Churrosoft/OpenEFI-Wideband/carrier_fw/src/can/readme.md

esta libreria se encarga de todo el manejo del CAN-Bus hacia el exterior,
es configurable un solo "modulo/protocolo" a utilizar de momento (si es que lo termino en algun momento)
