Churrosoft/OpenEFI-Wideband/pcb/wideband_v3/3D/DL7A-3 RED.step

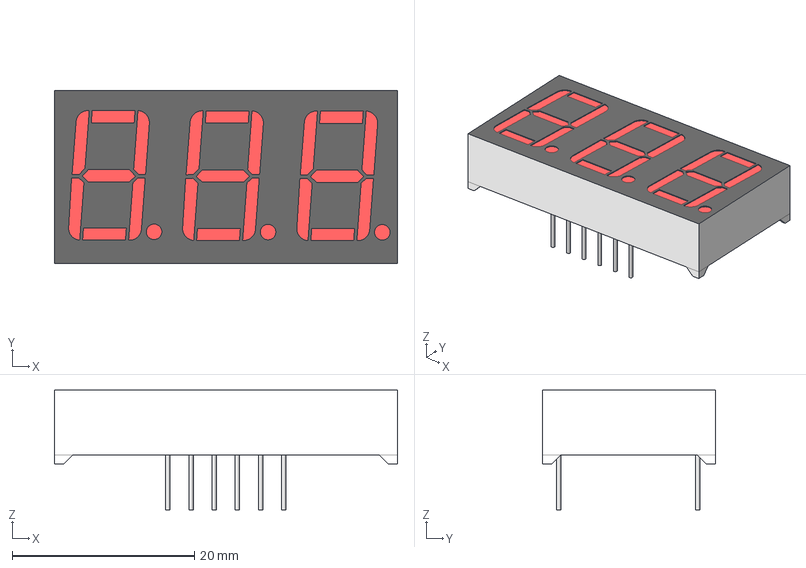
[picture p1: CAD file, 2023-12-04]
pcb/wideband_v3/3D/DL7A-3 RED.step
37.6 x 19.0 x 13.1 mm
