Churrosoft/OpenEFI-Wideband/pcb/wideband_v3/3D/39-28-1043--3DModel-STEP-361473.STEP

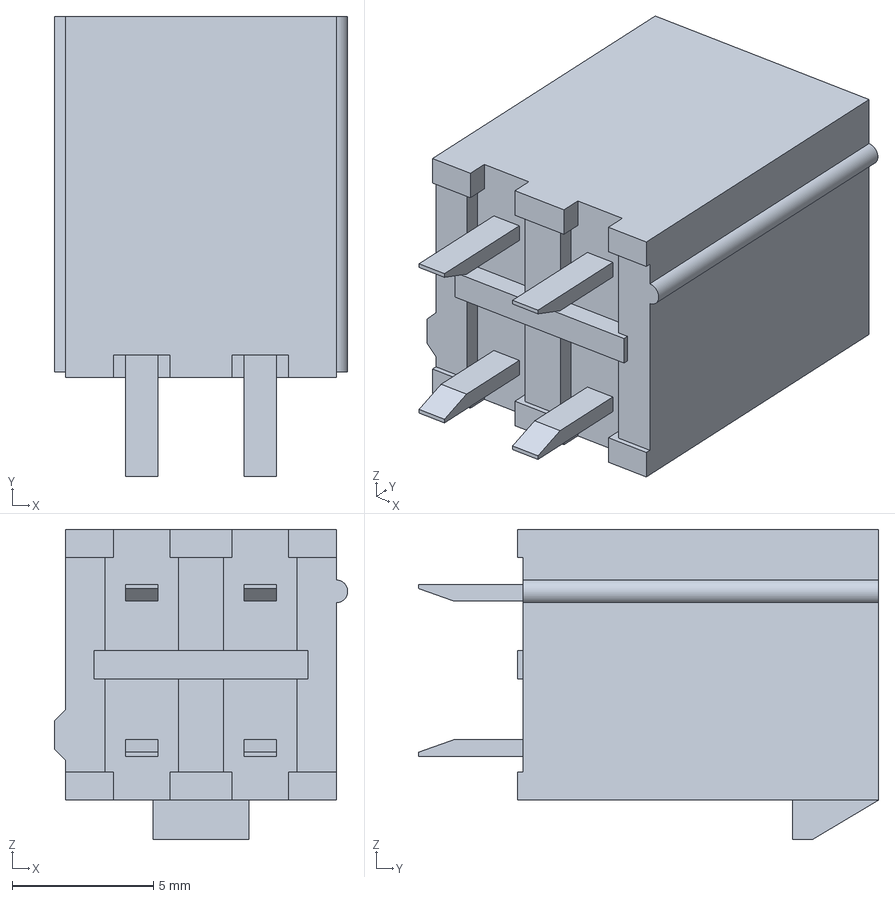
[picture p2: CAD file, 2023-12-04]
pcb/wideband_v3/3D/39-28-1043--3DModel-STEP-361473.STEP
10.4 x 16.3 x 11.0 mm
