Churrosoft/OpenEFI-Wideband/pcb/wideband_v3/3D/462071012.stp

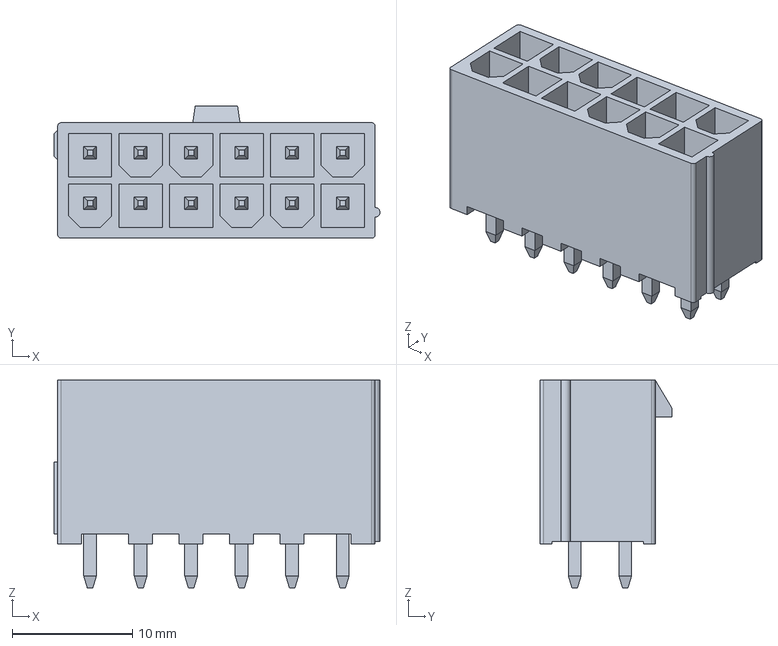
[picture p3: CAD file, 2023-12-04]
pcb/wideband_v3/3D/462071012.stp
27.1 x 11.0 x 17.3 mm
