Churrosoft/OpenEFI-Wideband/pcb/wideband_v3/displays/7_Segment_LED_v1/7_Segment_LED_v1.kicad_pcb

## KiCad design pcb/wideband_v3/displays/7_Segment_LED_v1/7_Segment_LED_v1.kicad_pcb (2024-04-12, an earlier design)

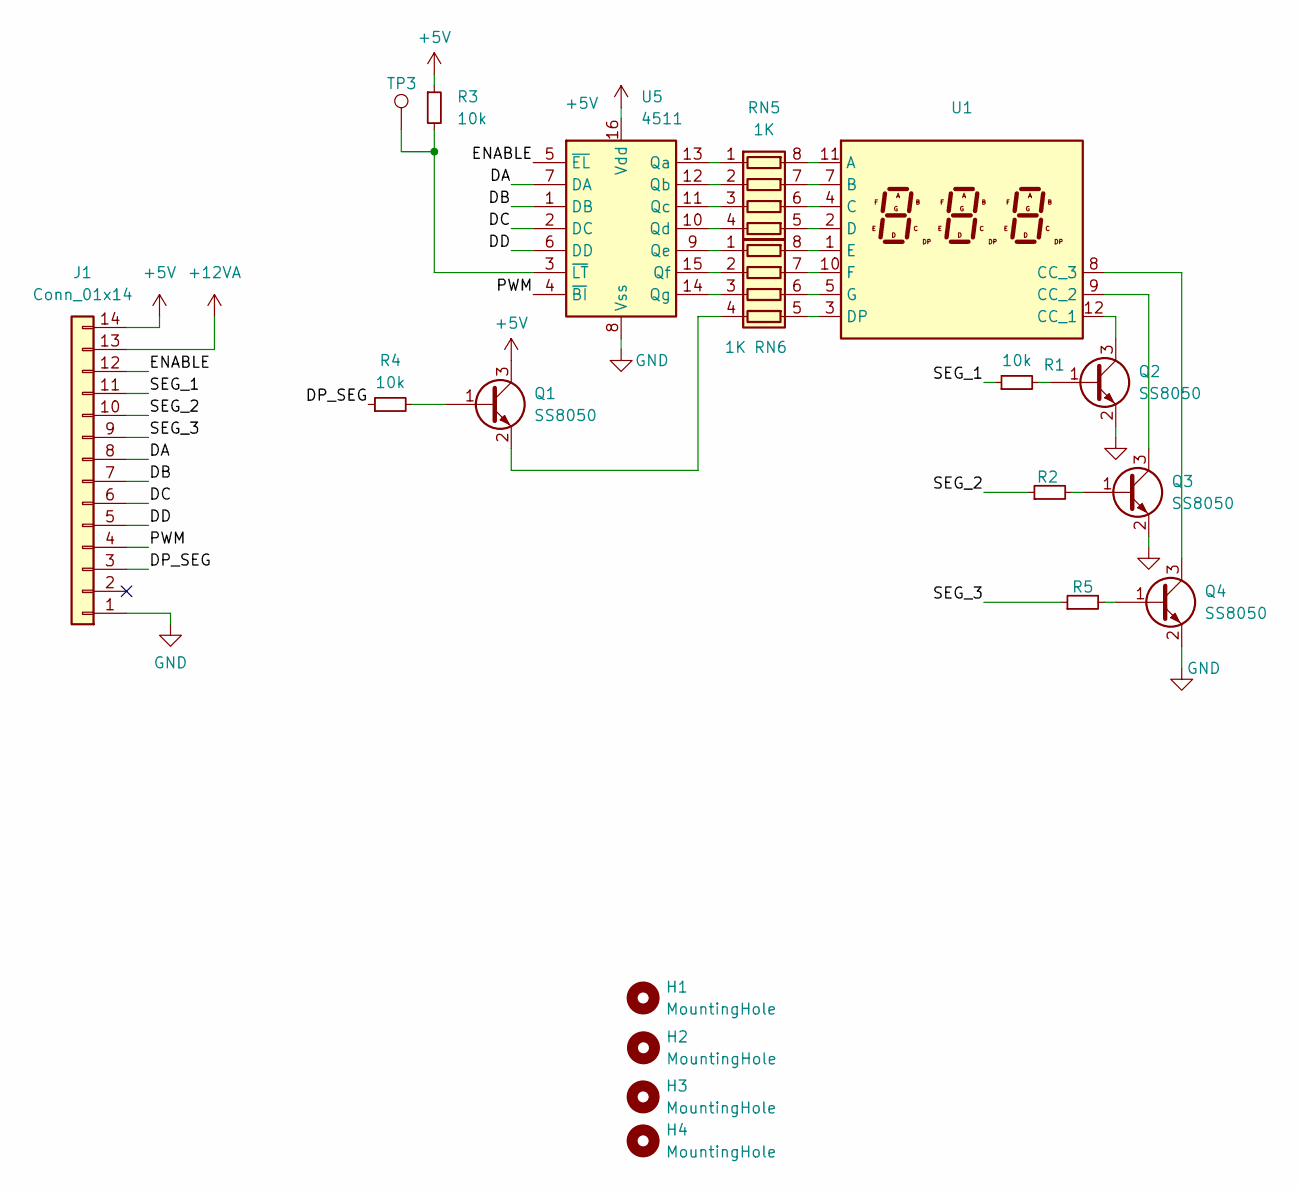
[picture p4: schematic 7_Segment_LED_v1.kicad_sch]

Parts:
H1, H2, H3, H4: MountingHole; MountingHole_3.2mm_M3_Pad_Via
J1: Conn_01x14; PinHeader_2x07_P2.54mm_Vertical
Q1, Q2, Q3, Q4: SS8050; SOT-23-3; LCSC C2150
R1, R2, R3, R4, R5: 10k; R_0603_1608Metric
RN5, RN6: 1K; R_Array_Convex_4x0603; LCSC C160614
TP3: TestPoint; TestPoint_Pad_1.0x1.0mm
U1: PinHeader_2x12_P2.00mm_Vertical
U5: 4511; SOP-16_4.55x10.3mm_P1.27mm; LCSC C5145431

Connections:
+5V: J1.14, Q1.3 (C), R3.1, U5.16 (Vdd)
+12VA: J1.13
/DA: J1.8, U5.7 (DA)
/DB: J1.7, U5.1 (DB)
/DC: J1.6, U5.2 (DC)
/DD: J1.5, U5.6 (DD)
/DP_SEG: J1.3, R4.1
/ENABLE: J1.12, U5.5 (~EL)
/PWM: J1.4, U5.4 (~BI)
/SEG_1: J1.11, R1.1
/SEG_2: J1.10, R2.1
/SEG_3: J1.9, R5.1
GND: J1.1, Q2.2 (E), Q3.2 (E), Q4.2 (E), U5.8 (Vss)
unnamed: Q1.1 (B), R4.2
unnamed: Q1.2 (E), RN6.4 (R4.1)
unnamed: Q2.1 (B), R1.2
unnamed: Q2.3 (C), U1.12 (CC_1)
unnamed: Q3.1 (B), R2.2
unnamed: Q3.3 (C), U1.9 (CC_2)
unnamed: Q4.1 (B), R5.2
unnamed: Q4.3 (C), U1.8 (CC_3)
unnamed: RN5.1 (R1.1), U5.13 (Qa)
unnamed: RN5.8 (R1.2), U1.11 (A)
unnamed: RN5.2 (R2.1), U5.12 (Qb)
unnamed: RN5.7 (R2.2), U1.7 (B)
unnamed: RN5.3 (R3.1), U5.11 (Qc)
unnamed: RN5.6 (R3.2), U1.4 (C)
unnamed: RN5.4 (R4.1), U5.10 (Qd)
unnamed: RN5.5 (R4.2), U1.2 (D)
unnamed: RN6.1 (R1.1), U5.9 (Qe)
unnamed: RN6.8 (R1.2), U1.1 (E)
unnamed: RN6.2 (R2.1), U5.15 (Qf)
unnamed: RN6.7 (R2.2), U1.10 (F)
unnamed: RN6.3 (R3.1), U5.14 (Qg)
unnamed: RN6.6 (R3.2), U1.5 (G)
unnamed: RN6.5 (R4.2), U1.3 (DP)
unnamed: R3.2, TP3.1, U5.3 (~LT)

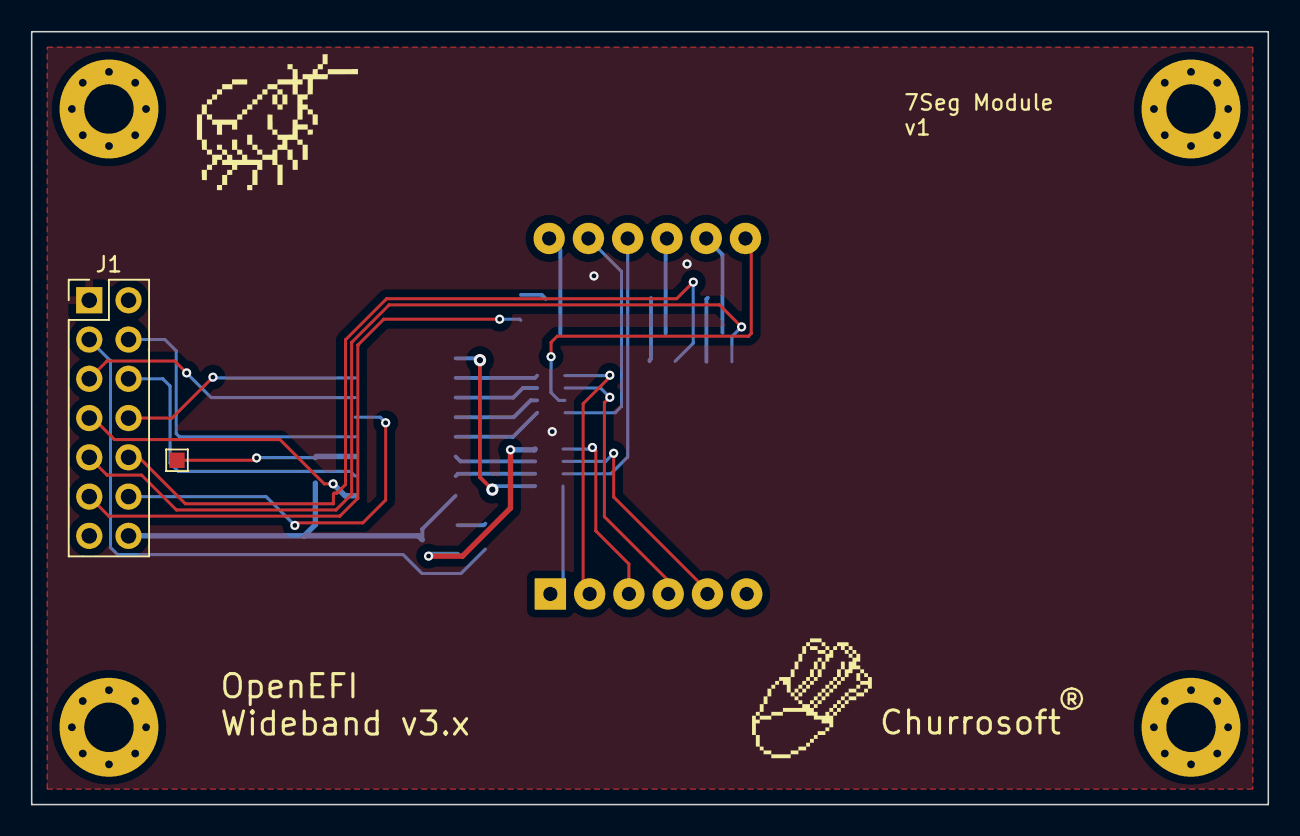
[picture p5: board 7_Segment_LED_v1.kicad_pcb from above]

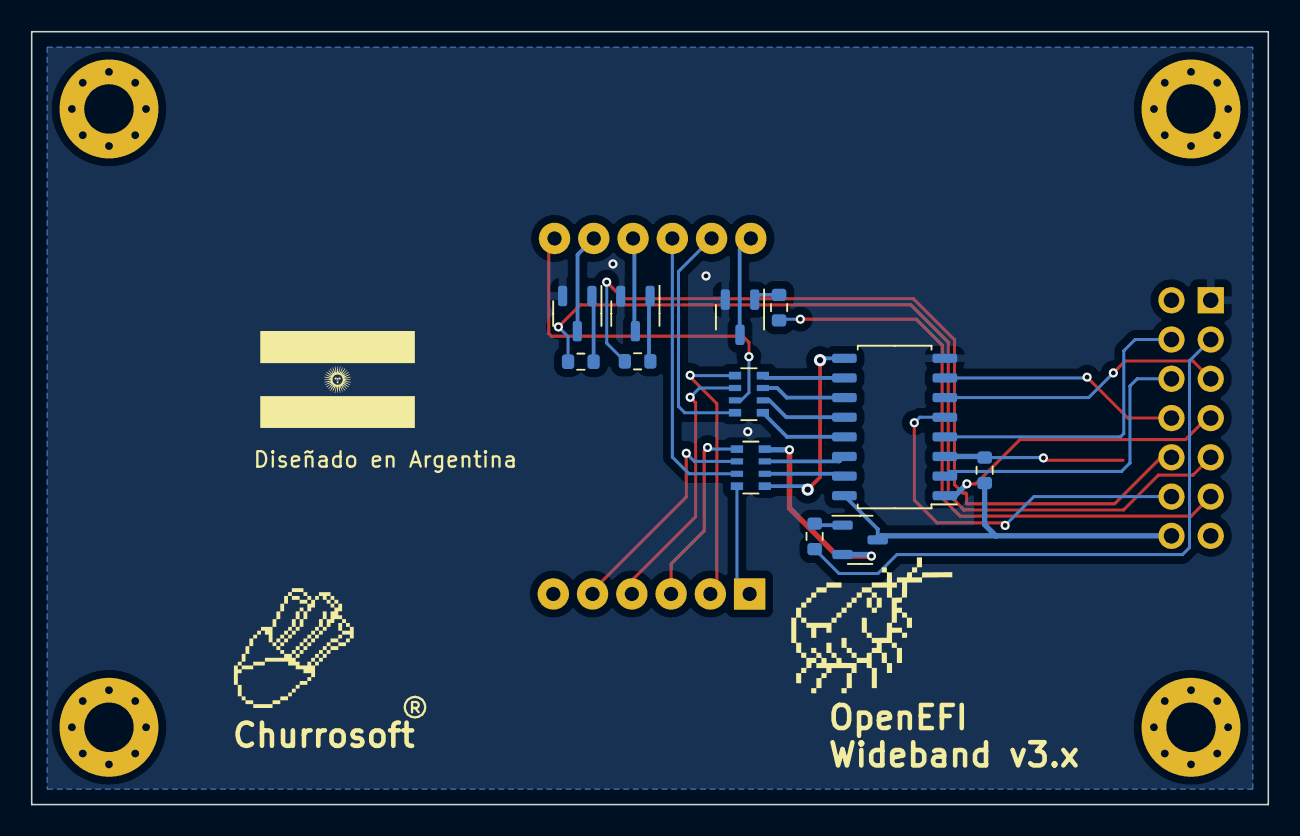
[picture p6: board 7_Segment_LED_v1.kicad_pcb from below]

Board: 2 copper layers, 80.0 x 50.0 mm, 19 parts (12 on the bottom side), 36 nets.
