Churrosoft/OpenEFI-Wideband/pcb/wideband_v3/Wideband_v3.kicad_pcb

## KiCad design pcb/wideband_v3/Wideband_v3.kicad_pcb (2024-04-07)

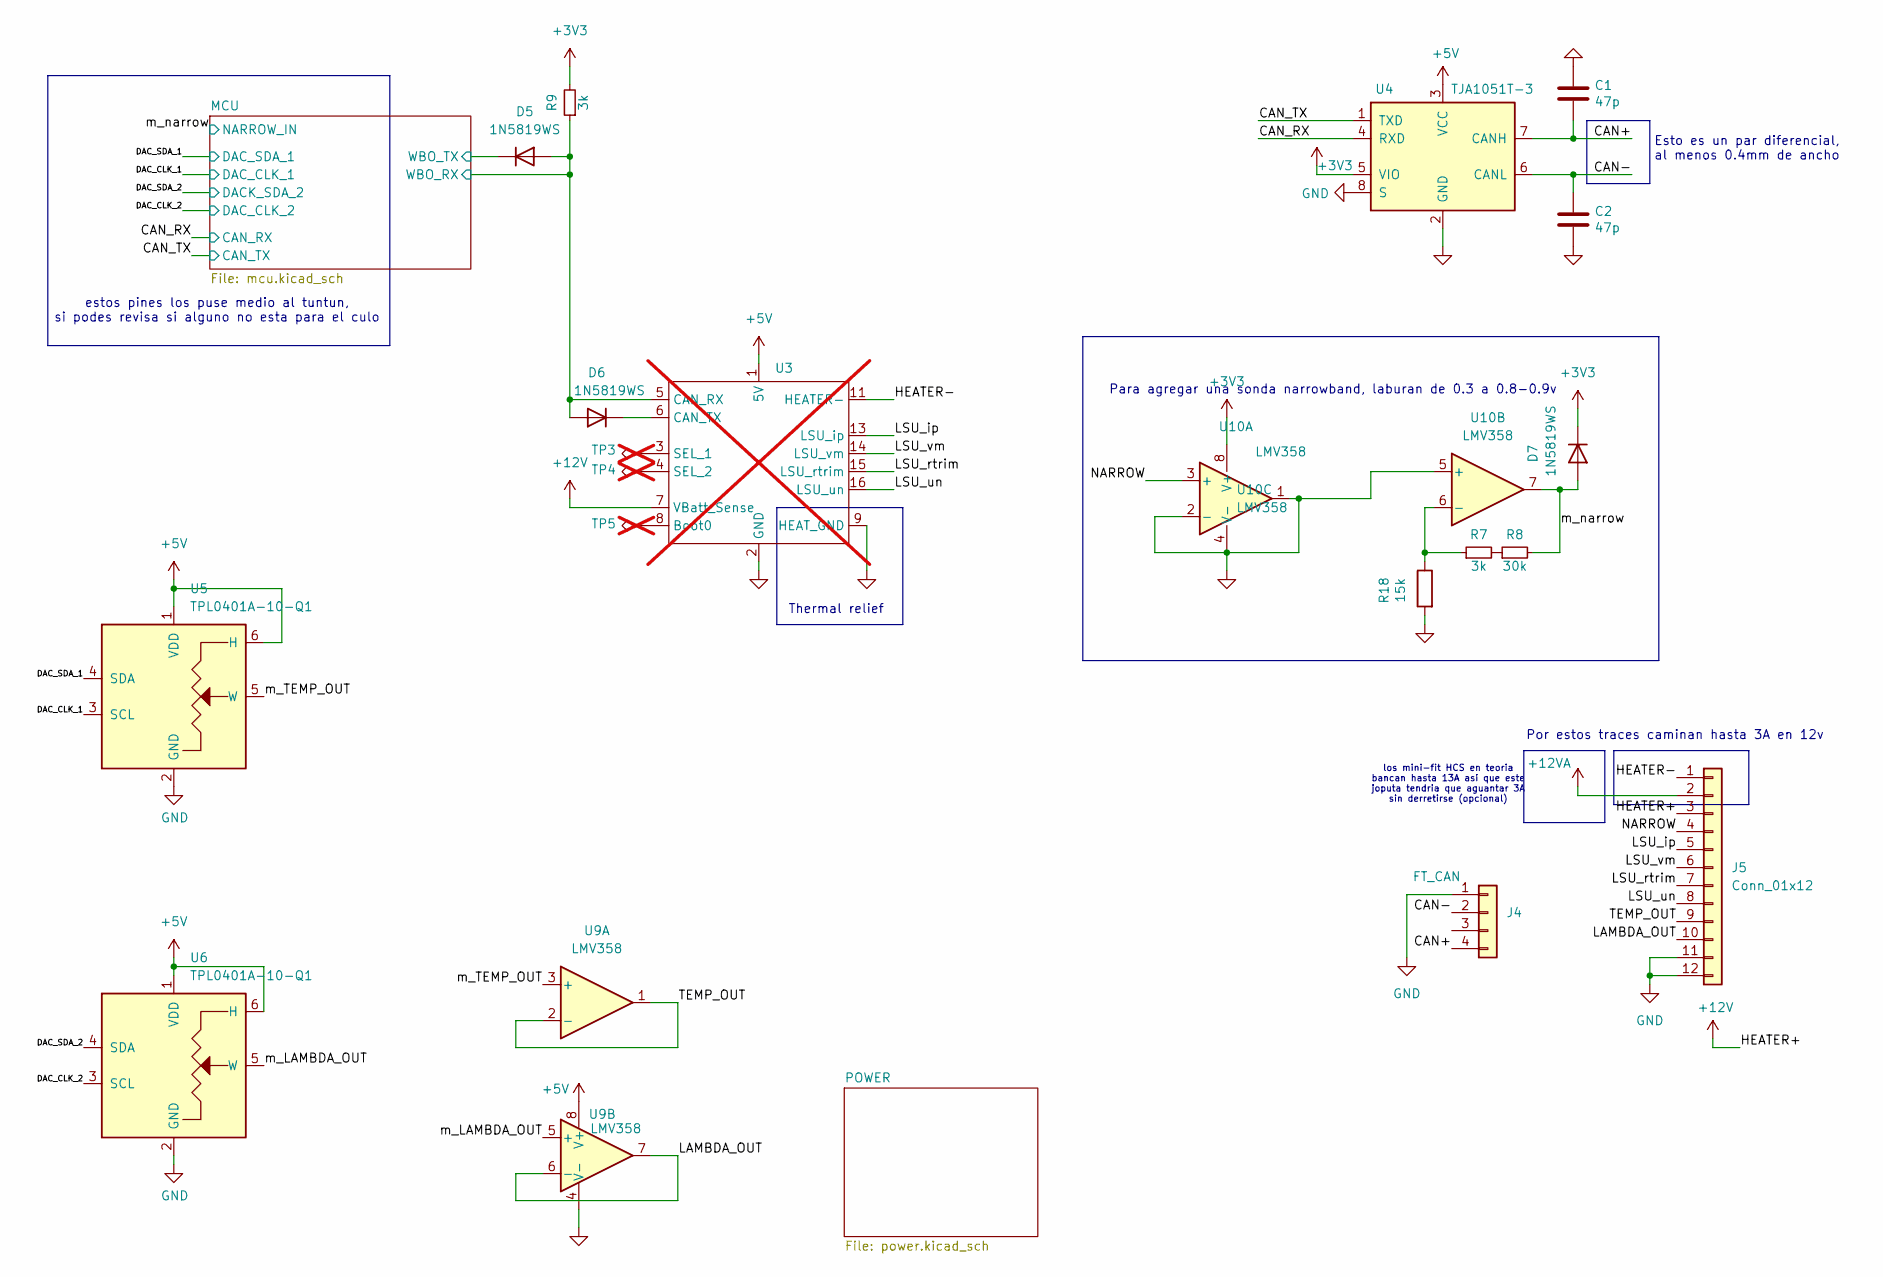
[picture p7: schematic Wideband_v3.kicad_sch, OpenEFI WBO Carrier Board]

Parts:
C1, C2: 47p; C_0603_1608Metric; LCSC C105622
D5, D6, D7: 1N5819WS; D_SOD-323F; LCSC C191023
J4: FT_CAN; Molex_Mini-Fit_Jr_5566-04A_2x02_P4.20mm_Vertical; LCSC C586650
J5: Conn_01x12; Molex_Mini-Fit_Jr_5566-12A2_2x06_P4.20mm_Vertical
R7, R9: 3k; R_0603_1608Metric; LCSC C4211
R8: 30k; R_0603_1608Metric; LCSC C22984
R18: 15k; R_0603_1608Metric; LCSC C100780
TP3, TP4, TP5: TestPoint_Alt; TestPoint_Pad_1.0x1.0mm; not fitted
U3: RusEFI_WBO; not fitted
U4: TJA1051T-3; SOP-8_3.9x4.9mm_P1.27mm; LCSC C5342108
U5, U6: TPL0401A-10-Q1; Texas_R-PDSO-G6; LCSC C2666599
U9, U10: LMV358; SOIC-8_3.9x4.9mm_P1.27mm; LCSC C63813

Connections:
+3V3: D7.1 (K), R9.2, U4.5 (VIO), U10.8 (V+); also elsewhere on the board
+5V: U3.1 (5V), U4.3 (VCC), U5.1 (VDD), U5.6 (H), U6.1 (VDD), U6.6 (H), U9.8 (V+); also elsewhere on the board
+12V: J5.3, U3.7 (VBatt_Sense); also elsewhere on the board
+12VA: J5.2; also elsewhere on the board
/CAN+: C1.2, J4.4, U4.7 (CANH)
/CAN-: C2.1, J4.2, U4.6 (CANL)
/CAN_RX: U4.4 (RXD); also elsewhere on the board
/CAN_TX: U4.1 (TXD); also elsewhere on the board
/DAC_CLK_1: U5.3 (SCL); also elsewhere on the board
/DAC_CLK_2: U6.3 (SCL); also elsewhere on the board
/DAC_SDA_1: U5.4 (SDA); also elsewhere on the board
/DAC_SDA_2: U6.4 (SDA); also elsewhere on the board
/HEATER-: J5.1, U3.11 (HEATER-), U3.12 (HEATER-)
/LAMBDA_OUT: J5.10, U9.6 (-), U9.7
/LSU_ip: J5.5, U3.13 (LSU_ip)
/LSU_rtrim: J5.7, U3.15 (LSU_rtrim)
/LSU_un: J5.8, U3.16 (LSU_un)
/LSU_vm: J5.6, U3.14 (LSU_vm)
/MCU/WBO_RX: D5.2 (A), D6.2 (A), R9.1, U3.5 (CAN_RX); also elsewhere on the board
/MCU/WBO_TX: D5.1 (K); also elsewhere on the board
/NARROW: J5.4, U10.3 (+)
/TEMP_OUT: J5.9, U9.1, U9.2 (-)
/m_LAMBDA_OUT: U6.5 (W), U9.5 (+)
/m_TEMP_OUT: U5.5 (W), U9.3 (+)
/m_narrow: D7.2 (A), R8.2, U10.7; also elsewhere on the board
GND: C1.1, C2.2, J4.1, J5.11, J5.12, R18.2, U3.2 (GND), U3.9 (HEAT_GND), U3.10 (HEAT_GND2), U4.2 (GND), U4.8 (S), U5.2 (GND), U6.2 (GND), U9.4 (V-), U10.1, U10.2 (-), U10.4 (V-), U10.5 (+); also elsewhere on the board
unnamed: D6.1 (K), U3.6 (CAN_TX)
unnamed: R7.2, R8.1
unnamed: TP5.1, U3.8 (Boot0)
unnamed: TP3.1, U3.3 (SEL_1)
unnamed: TP4.1, U3.4 (SEL_2)
unnamed: R7.1, R18.1, U10.6 (-)

Notes on the sheet:
Thermal relief
Para agregar una sonda narrowband, laburan de 0.3 a 0.8-0.9v
Esto es un par diferencial, al menos 0.4mm de ancho
Por estos traces caminan hasta 3A en 12v
los mini-fit HCS en teoria bancan hasta 13A asi que este joputa tendria que aguantar 3A sin derretirse (opcional)
estos pines los puse medio al tuntun, si podes revisa si alguno no esta para el culo

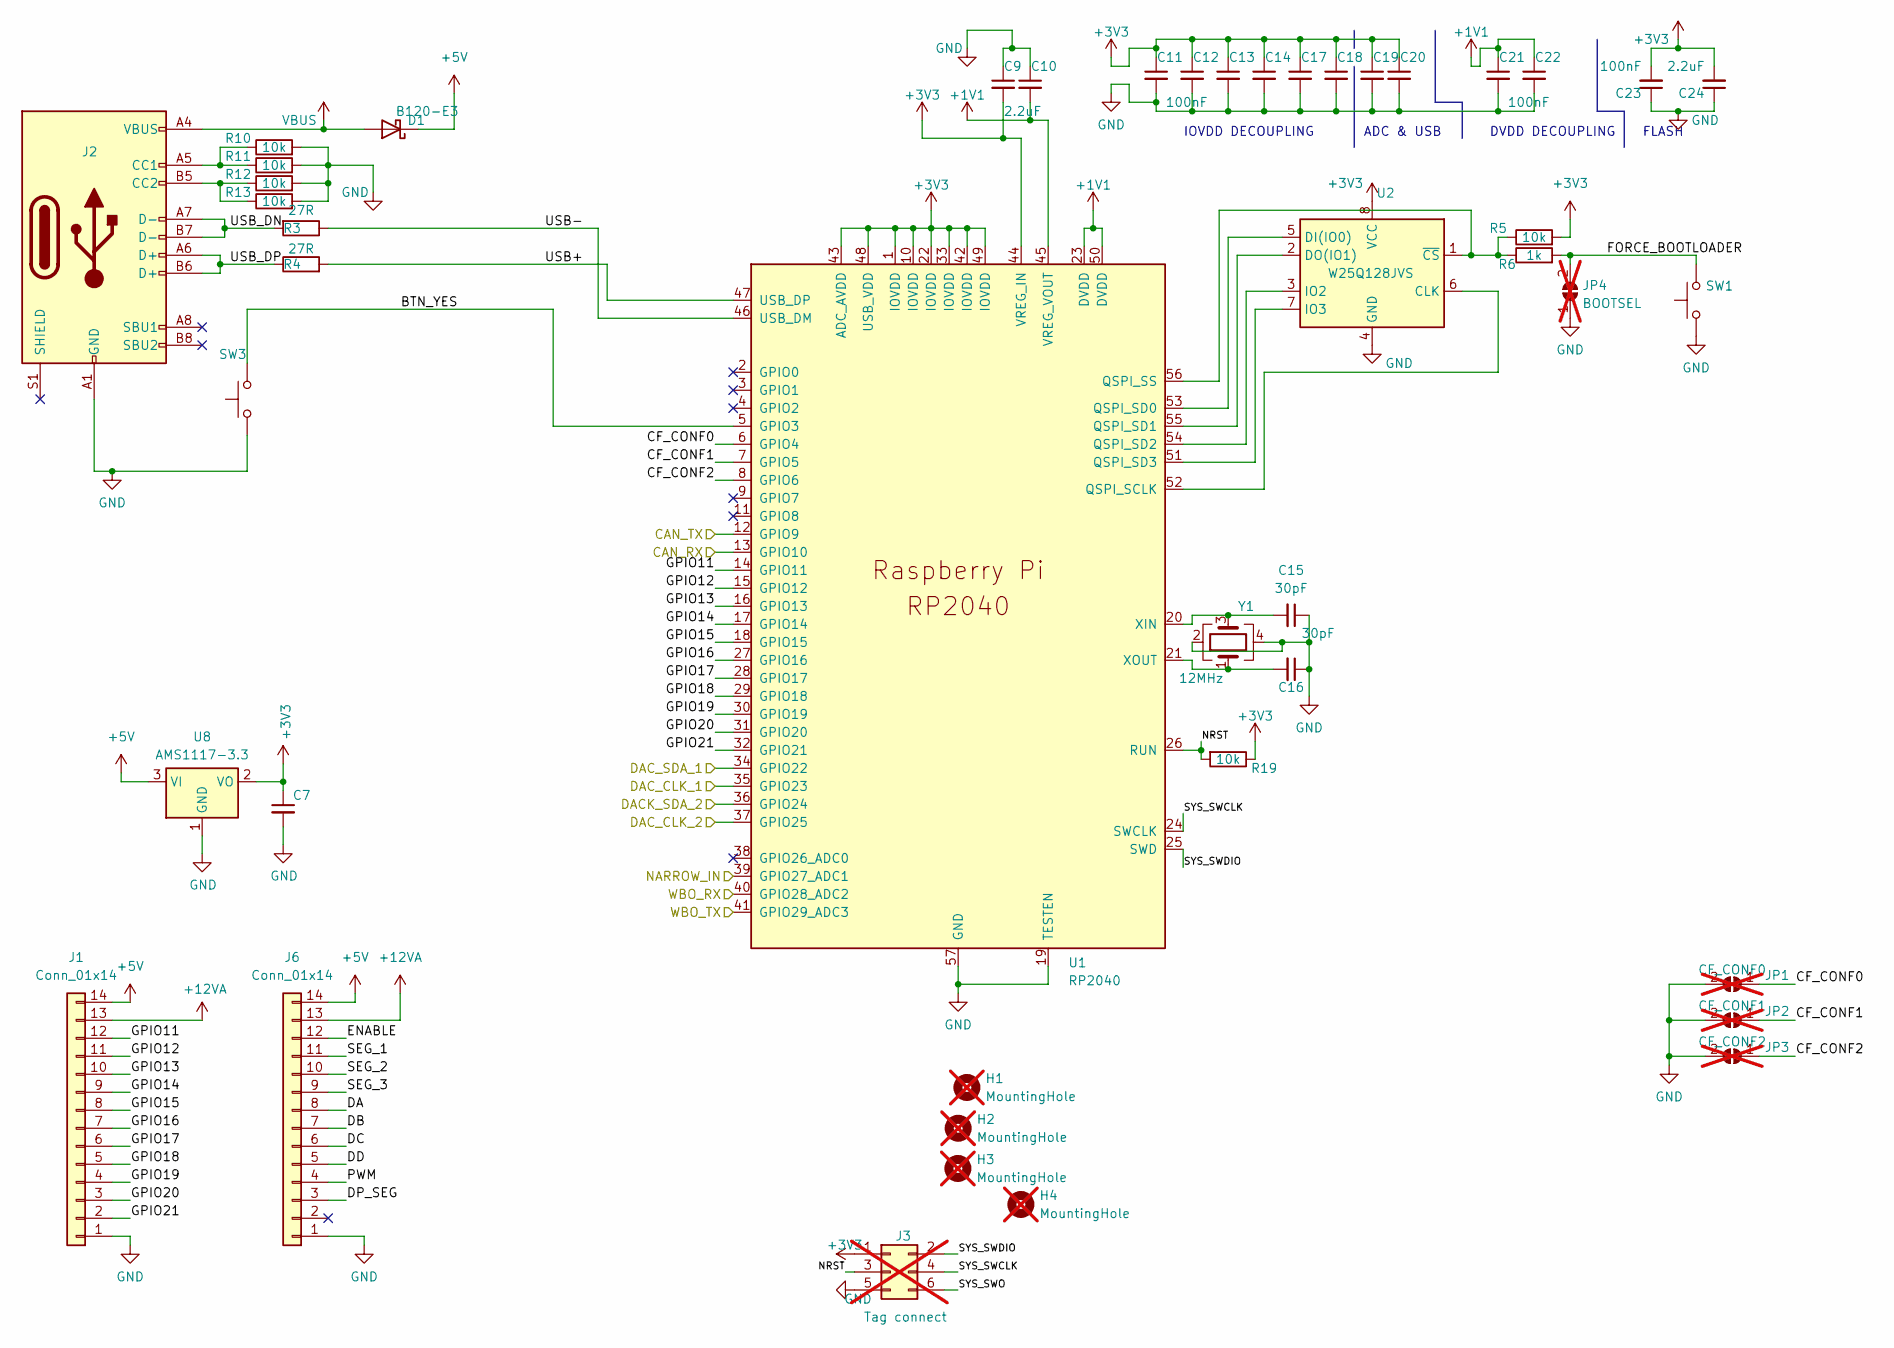
[picture p8: schematic mcu.kicad_sch, OpenEFI WBO Carrier Board]

Parts:
C7, C11, C12, C13, C14, C17, C18, C19, C20, C21, C22, C23: 100nF; C_0603_1608Metric; LCSC C14663
C9, C10, C24: 2.2uF; C_0805_2012Metric; LCSC C49217
C15, C16: 30pF; C_0402_1005Metric; LCSC C18164620
D1: B120-E3; D_SMA; LCSC C84343
H1, H2, H3, H4: MountingHole; MountingHole_3.2mm_M3_Pad_Via; not fitted
J1: Conn_01x14; PinHeader_2x07_P2.54mm_Vertical; LCSC C7494795
J2: USB_C_Receptacle_USB2.0; USB_C_Receptacle_HRO_TYPE-C-31-M-12; LCSC C165948
J3: Tag connect; Tag-Connect_TC2030-IDC-NL_2x03_P1.27mm_Vertical; not fitted
J6: Conn_01x14; PinHeader_2x07_P2.54mm_Vertical
JP1: CF_CONF0; SolderJumper-2_P1.3mm_Open_TrianglePad1.0x1.5mm; not fitted
JP2: CF_CONF1; SolderJumper-2_P1.3mm_Open_TrianglePad1.0x1.5mm; not fitted
JP3: CF_CONF2; SolderJumper-2_P1.3mm_Open_TrianglePad1.0x1.5mm; not fitted
JP4: BOOTSEL; SolderJumper-2_P1.3mm_Open_TrianglePad1.0x1.5mm; not fitted
R3, R4: 27R; R_0603_1608Metric; LCSC C25190
R5, R10, R11, R12, R13, R19: 10k; R_0603_1608Metric; LCSC C115324
R6: 1k; R_0603_1608Metric; LCSC C21190
SW1: Key0; SW_Push_1P1T_XKB_TS-1187A; LCSC C412370
SW3: Key1; SW_SPST_Omron_B3F-315x_Angled; LCSC C2798927
U1: RP2040; QFN-56-1EP_7x7mm_P0.4mm_EP3.2x3.2mm; LCSC C2040
U2: W25Q128JVS; SOIC-8_5.23x5.23mm_P1.27mm; LCSC C97521
U8: AMS1117-3.3; SOT-223-3_TabPin2; LCSC C6186
Y1: 12MHz; Crystal_SMD_3225-4Pin_3.2x2.5mm; LCSC C9002

Connections:
+1V1: C10.2, C21.1, C22.1, U1.23 (DVDD), U1.45 (VREG_VOUT), U1.50 (DVDD)
+3V3: C7.1, C9.2, C11.1, C12.1, C13.1, C14.1, C17.1, C18.1, C19.1, C20.1, C23.2, C24.2, J3.1, R5.2, R19.1, U1.1 (IOVDD), U1.10 (IOVDD), U1.22 (IOVDD), U1.33 (IOVDD), U1.42 (IOVDD), U1.43 (ADC_AVDD), U1.44 (VREG_IN), U1.48 (USB_VDD), U1.49 (IOVDD), U2.8 (VCC), U8.2 (VO); also elsewhere on the board
+5V: D1.1 (K), J1.14, J6.14, U8.3 (VI); also elsewhere on the board
+12VA: J1.13, J6.13; also elsewhere on the board
/CAN_RX: U1.13 (GPIO10); also elsewhere on the board
/CAN_TX: U1.12 (GPIO9); also elsewhere on the board
/DAC_CLK_1: U1.35 (GPIO23); also elsewhere on the board
/DAC_CLK_2: U1.37 (GPIO25); also elsewhere on the board
/DAC_SDA_1: U1.34 (GPIO22); also elsewhere on the board
/DAC_SDA_2: U1.36 (GPIO24); also elsewhere on the board
/MCU/BTN_YES: SW3.2, U1.5 (GPIO3)
/MCU/CF_CONF0: JP1.1 (A), U1.6 (GPIO4)
/MCU/CF_CONF1: JP2.1 (A), U1.7 (GPIO5)
/MCU/CF_CONF2: JP3.1 (A), U1.8 (GPIO6)
/MCU/FORCE_BOOTLOADER: JP4.2 (B), R6.2, SW1.2
/MCU/GPIO11: J1.12, U1.14 (GPIO11)
/MCU/GPIO12: J1.11, U1.15 (GPIO12)
/MCU/GPIO13: J1.10, U1.16 (GPIO13)
/MCU/GPIO14: J1.9, U1.17 (GPIO14)
/MCU/GPIO15: J1.8, U1.18 (GPIO15)
/MCU/GPIO16: J1.7, U1.27 (GPIO16)
/MCU/GPIO17: J1.6, U1.28 (GPIO17)
/MCU/GPIO18: J1.5, U1.29 (GPIO18)
/MCU/GPIO19: J1.4, U1.30 (GPIO19)
/MCU/GPIO20: J1.3, U1.31 (GPIO20)
/MCU/GPIO21: J1.2, U1.32 (GPIO21)
/MCU/NRST: J3.3, R19.2, U1.26 (RUN)
/MCU/SYS_SWCLK: J3.4, U1.24 (SWCLK)
/MCU/SYS_SWDIO: J3.2, U1.25 (SWD)
/MCU/SYS_SWO: J3.6
/MCU/USB+: R4.2, U1.47 (USB_DP)
/MCU/USB-: R3.1, U1.46 (USB_DM)
/MCU/USB_DN: J2.A7 (D-), J2.B7 (D-), R3.2
/MCU/USB_DP: J2.A6 (D+), J2.B6 (D+), R4.1
/MCU/WBO_RX: U1.40 (GPIO28_ADC2); also elsewhere on the board
/MCU/WBO_TX: U1.41 (GPIO29_ADC3); also elsewhere on the board
/m_narrow: U1.39 (GPIO27_ADC1); also elsewhere on the board
GND: C7.2, C9.1, C10.1, C11.2, C12.2, C13.2, C14.2, C15.1, C16.1, C17.2, C18.2, C19.2, C20.2, C21.2, C22.2, C23.1, C24.1, J1.1, J2.A1 (GND), J2.A12 (GND), J2.B1 (GND), J2.B12 (GND), J3.5, JP1.2 (B), JP2.2 (B), JP3.2 (B), JP4.1 (A), R10.2, R11.2, R12.2, R13.2, SW1.1, SW3.1, U1.19 (TESTEN), U1.57 (GND), U2.4 (GND), U8.1 (GND), Y1.2, Y1.4; also elsewhere on the board
unnamed: J2.A5 (CC1), R10.1, R11.1
unnamed: J2.B5 (CC2), R12.1, R13.1
unnamed: U1.52 (QSPI_SCLK), U2.6 (CLK)
unnamed: U1.53 (QSPI_SD0), U2.5 (DI(IO0))
unnamed: U1.55 (QSPI_SD1), U2.2 (DO(IO1))
unnamed: U1.54 (QSPI_SD2), U2.3 (IO2)
unnamed: U1.51 (QSPI_SD3), U2.7 (IO3)
unnamed: R5.1, R6.1, U1.56 (QSPI_SS), U2.1 (~CS)
unnamed: C15.2, U1.20 (XIN), Y1.3
unnamed: C16.2, U1.21 (XOUT), Y1.1
VBUS: D1.2 (A), J2.A4 (VBUS), J2.A9 (VBUS), J2.B4 (VBUS), J2.B9 (VBUS)

Notes on the sheet:
FLASH
ADC & USB
DVDD DECOUPLING
IOVDD DECOUPLING

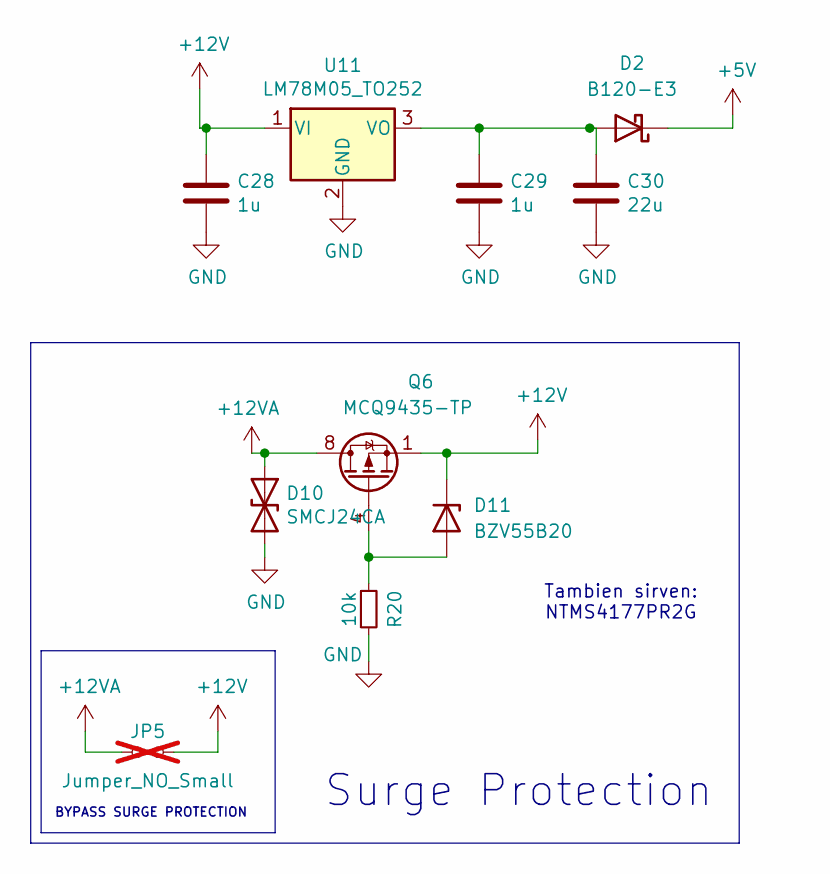
[picture p9: schematic power.kicad_sch, OpenEFI WBO Carrier Board]

Parts:
C28, C29: 1u; C_0603_1608Metric; LCSC C15849
C30: 22u; C_0805_2012Metric; LCSC C45783
D2: B120-E3; D_SMA; LCSC C84343
D10: SMCJ24CA; D_SMC; LCSC C151279
D11: BZV55B20; D_MiniMELF; LCSC C550392
JP5: Jumper_NO_Small; SolderJumper-2_P1.3mm_Open_RoundedPad1.0x1.5mm; not fitted
Q6: MCQ9435-TP; SOIC-8_3.9x4.9mm_P1.27mm; LCSC C586650
R20: 10k; R_0603_1608Metric; LCSC C115324
U11: LM78M05_TO252; TO-252-2; LCSC C58069

Connections:
+5V: D2.1 (K); also elsewhere on the board
+12V: C28.1, D11.1 (K), JP5.2, Q6.1 (S), Q6.2 (S), Q6.3 (S), U11.1 (VI); also elsewhere on the board
+12VA: D10.1 (A1), JP5.1, Q6.5 (D), Q6.6 (D), Q6.7 (D), Q6.8 (D); also elsewhere on the board
GND: C28.2, C29.2, C30.2, D10.2 (A2), R20.2, U11.2 (GND); also elsewhere on the board
unnamed: C29.1, C30.1, D2.2 (A), U11.3 (VO)
unnamed: D11.2 (A), Q6.4 (G), R20.1

Notes on the sheet:
BYPASS SURGE PROTECTION
Tambien sirven: NTMS4177PR2G
Surge Protection

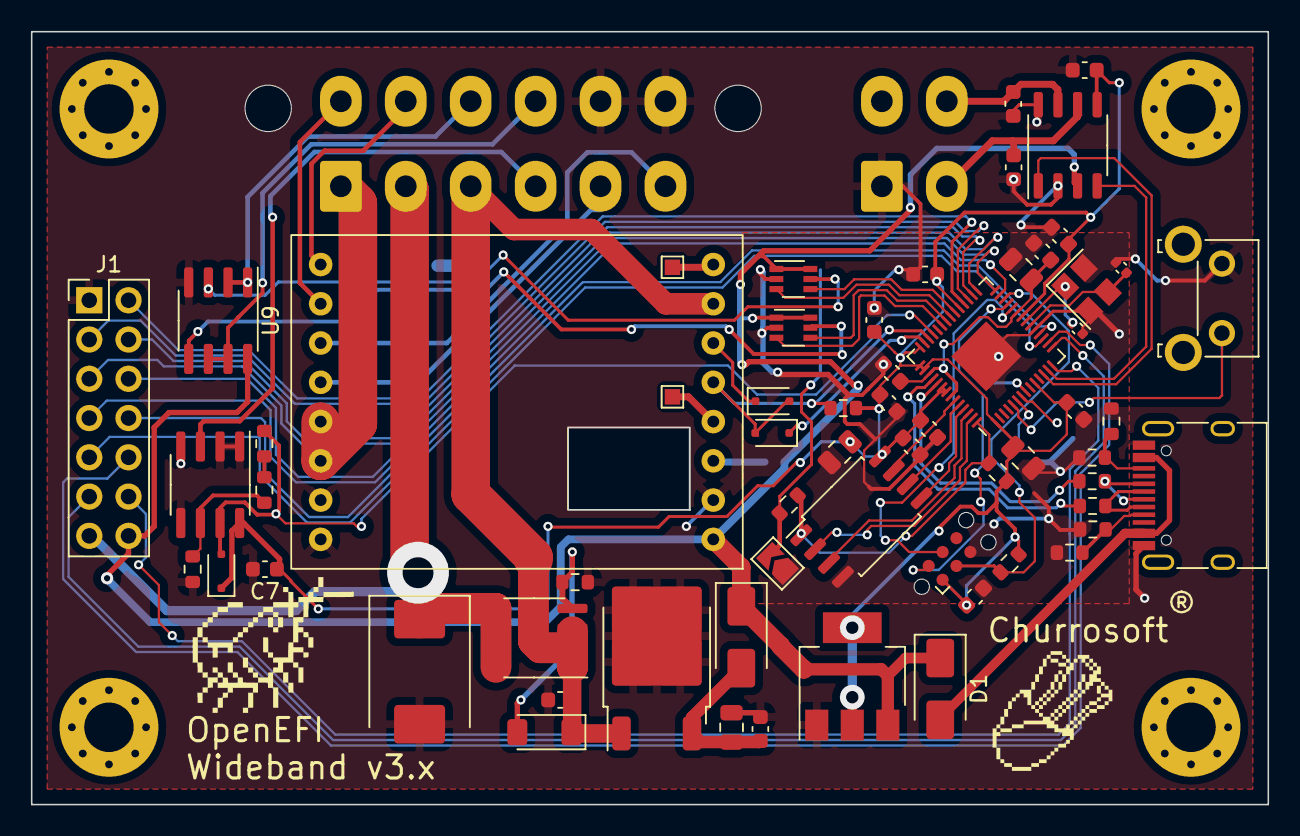
[picture p10: board Wideband_v3.kicad_pcb from above]

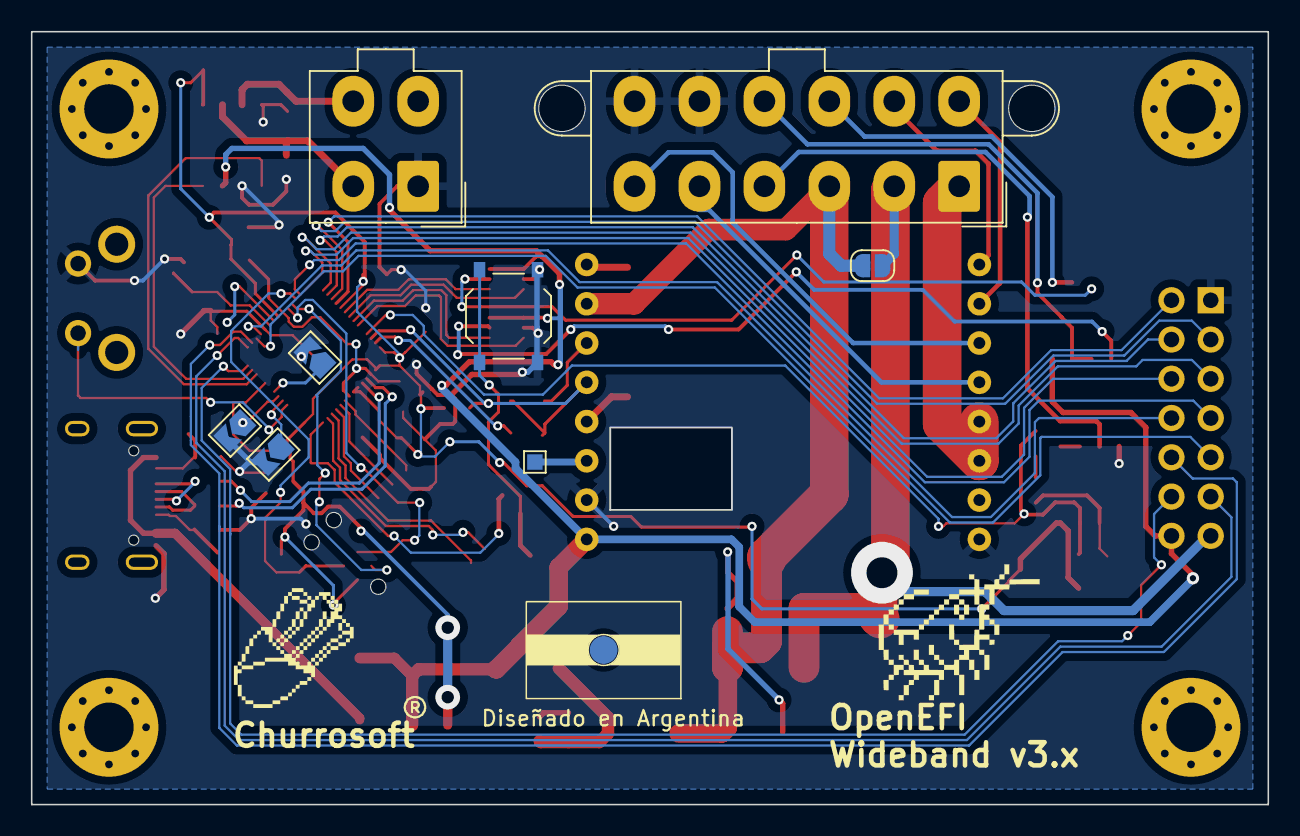
[picture p11: board Wideband_v3.kicad_pcb from below]

Board: 2 copper layers, 80.0 x 50.0 mm, 74 parts (8 on the bottom side), 69 nets.
