Churrosoft/OpenEFI-Wideband/pcb/wideband_v2/wideband_v2.kicad_pcb

## KiCad design pcb/wideband_v2/wideband_v2.kicad_pcb (2022-07-13, an earlier design)

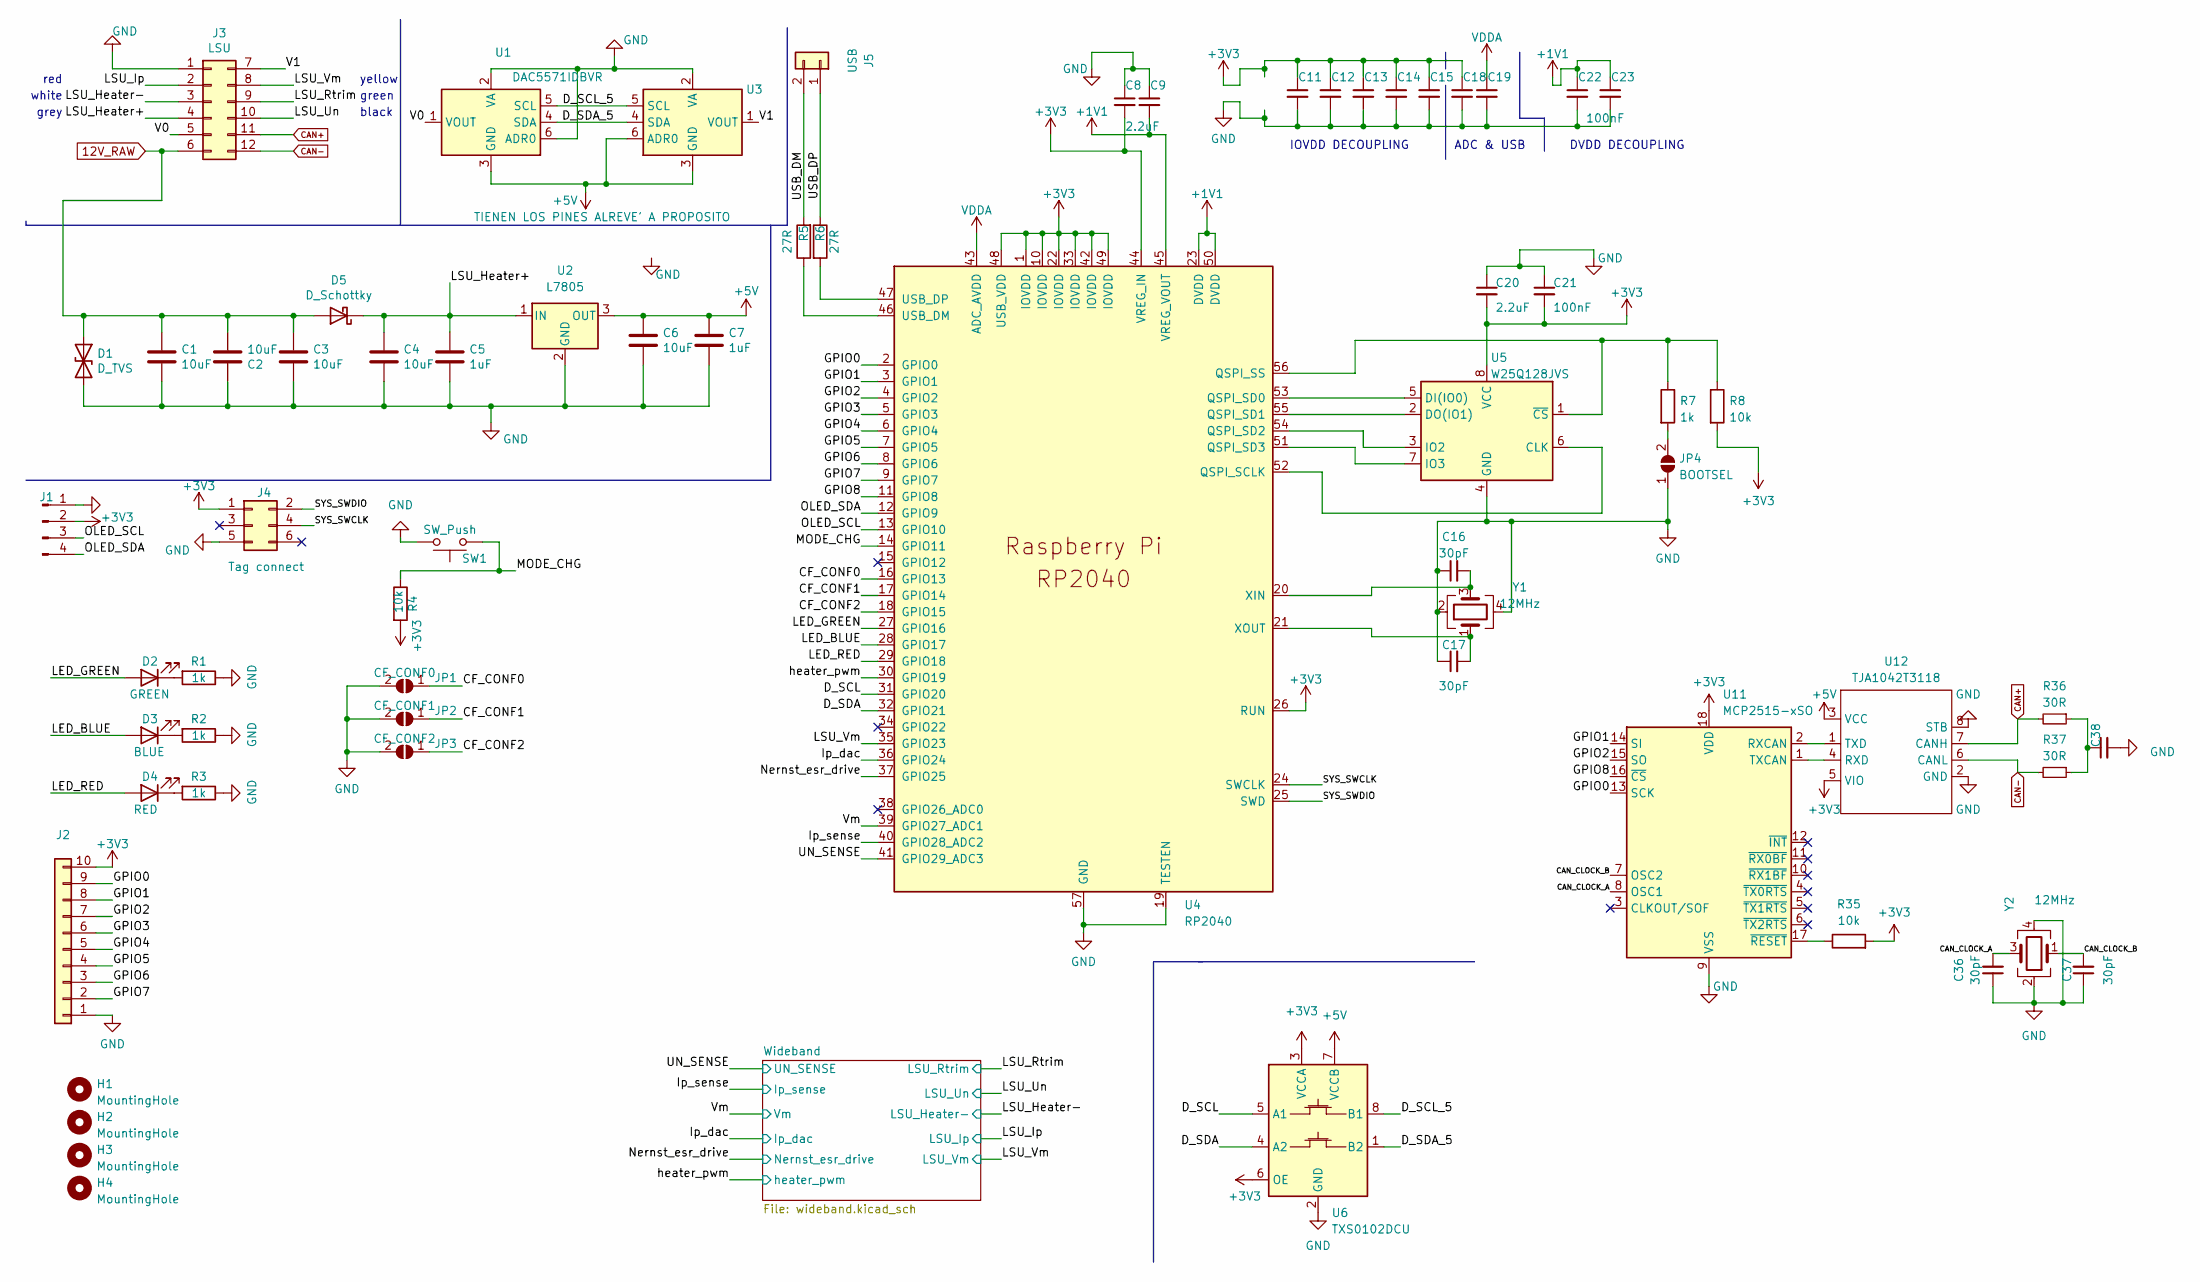
[picture p12: schematic wideband_v2.kicad_sch, Wideband sensor reader]

Parts:
C1, C2, C3, C4, C6: 10uF; C_1206_3216Metric; LCSC C13585
C5, C7: 1uF; C_0603_1608Metric; LCSC C15849
C8, C9, C20: 2.2uF; C_0603_1608Metric
C11, C12, C13, C14, C15, C18, C19, C21, C22, C23: 100nF; C_0603_1608Metric
C16, C17, C36, C37: 30pF; C_0603_1608Metric
C38: 4.7nF; C_0805_2012Metric; LCSC C77475
D1: D_TVS; D_SMC; LCSC C151279
D2: GREEN; LED_0603_1608Metric; LCSC C72043
D3: BLUE; LED_0603_1608Metric; LCSC C72041
D4: RED; LED_0603_1608Metric; LCSC C72041
D5: D_Schottky; D_SMA; LCSC C22452
H1, H2, H3, H4: MountingHole; MountingHole_2.2mm_M2
J1: DISPLAY; PinHeader_1x04_P2.54mm_Vertical
J2: GPIO; PinHeader_1x10_P2.00mm_Vertical
J3: LSU; Molex_Mini-Fit_Jr_5566-12A2_2x06_P4.20mm_Vertical
J4: Tag connect; Tag-Connect_TC2030-IDC-NL_2x03_P1.27mm_Vertical
J5: USB; PinHeader_1x02_P2.00mm_Vertical
JP1: CF_CONF0; SolderJumper-2_P1.3mm_Open_TrianglePad1.0x1.5mm
JP2: CF_CONF1; SolderJumper-2_P1.3mm_Open_TrianglePad1.0x1.5mm
JP3: CF_CONF2; SolderJumper-2_P1.3mm_Open_TrianglePad1.0x1.5mm
JP4: BOOTSEL; SolderJumper-2_P1.3mm_Open_TrianglePad1.0x1.5mm
R1, R2, R3, R7: 1k; R_0603_1608Metric
R4: 10k; R_0603_1608Metric; LCSC C25744
R5, R6: 27R; R_0603_1608Metric
R8, R35: 10k; R_0603_1608Metric
R36, R37: 30R; R_1206_3216Metric; LCSC C205298
SW1: SW_Push; SW_Tactile_SPST_Angled_PTS645Vx83-2LFS
U1: DAC5571IDBVR; SOT-23-6
U2: L7805; TO-220-3_Vertical
U3: DAC5571IDBVR; SOT-23-6; LCSC C24061
U4: RP2040; RP2040-QFN-56
U5: W25Q128JVS; SOIC-8_5.23x5.23mm_P1.27mm
U6: TXS0102DCU; VSSOP-8_2.3x2mm_P0.5mm
U11: MCP2515-xSO; SOIC-18W_7.5x11.6mm_P1.27mm
U12: TJA1042T3118; HTSOP-8-1EP_3.9x4.9mm_P1.27mm_EP2.4x3.2mm
Y1, Y2: 12MHz; Crystal_SMD_3225-4Pin_3.2x2.5mm; LCSC C9002

Connections:
12V_RAW: C1.1, C2.2, C3.1, D1.1 (A1), D5.2 (A), J3.6
+1V1: C9.2, C22.1, C23.1, U4.23 (DVDD), U4.45 (VREG_VOUT), U4.50 (DVDD)
+3V3: C8.2, C11.1, C12.1, C13.1, C14.1, C15.1, C18.1, C20.2, C21.2, J1.2, J2.10, J4.1, R4.2, R8.2, R35.2, U4.1 (IOVDD), U4.10 (IOVDD), U4.22 (IOVDD), U4.26 (RUN), U4.33 (IOVDD), U4.42 (IOVDD), U4.44 (VREG_IN), U4.48 (USB_VDD), U4.49 (IOVDD), U5.8 (VCC), U6.3 (VCCA), U6.6 (OE), U11.18 (VDD), U12.5 (VIO); also elsewhere on the board
+5V: C6.1, C7.1, U1.3 (GND), U2.3 (OUT), U3.3 (GND), U3.6 (ADR0), U6.7 (VCCB), U12.3 (VCC); also elsewhere on the board
/CAN_CLOCK_A: C36.2, U11.8 (OSC1), Y2.3
/CAN_CLOCK_B: C37.2, U11.7 (OSC2), Y2.1
/CF_CONF0: JP1.1 (A), U4.16 (GPIO13)
/CF_CONF1: JP2.1 (A), U4.17 (GPIO14)
/CF_CONF2: JP3.1 (A), U4.18 (GPIO15)
/D_SCL: U4.31 (GPIO20), U6.5 (A1)
/D_SCL_5: U1.5 (SCL), U3.5 (SCL), U6.8 (B1)
/D_SDA: U4.32 (GPIO21), U6.4 (A2)
/D_SDA_5: U1.4 (SDA), U3.4 (SDA), U6.1 (B2)
/GPIO0: J2.9, U4.2 (GPIO0), U11.13 (SCK)
/GPIO1: J2.8, U4.3 (GPIO1), U11.14 (SI)
/GPIO2: J2.7, U4.4 (GPIO2), U11.15 (SO)
/GPIO3: J2.6, U4.5 (GPIO3)
/GPIO4: J2.5, U4.6 (GPIO4)
/GPIO5: J2.4, U4.7 (GPIO5)
/GPIO6: J2.3, U4.8 (GPIO6)
/GPIO7: J2.2, U4.9 (GPIO7)
/GPIO8: U4.11 (GPIO8), U11.16 (~CS)
/Ip_dac: U4.36 (GPIO24); also elsewhere on the board
/Ip_sense: U4.40 (GPIO28_ADC2); also elsewhere on the board
/LED_BLUE: D3.2 (A), U4.28 (GPIO17)
/LED_GREEN: D2.2 (A), U4.27 (GPIO16)
/LED_RED: D4.2 (A), U4.29 (GPIO18)
/LSU_Heater+: C4.1, C5.1, D5.1 (K), J3.4, U2.1 (IN)
/LSU_Heater-: J3.3; also elsewhere on the board
/LSU_Ip: J3.2; also elsewhere on the board
/LSU_Rtrim: J3.9; also elsewhere on the board
/LSU_Un: J3.10; also elsewhere on the board
/LSU_Vm: J3.8, U4.35 (GPIO23); also elsewhere on the board
/MODE_CHG: R4.1, SW1.1, U4.14 (GPIO11)
/Nernst_esr_drive: U4.37 (GPIO25); also elsewhere on the board
/OLED_SCL: J1.3, U4.13 (GPIO10)
/OLED_SDA: J1.4, U4.12 (GPIO9)
/SYS_SWCLK: J4.4, U4.24 (SWCLK)
/SYS_SWDIO: J4.2, U4.25 (SWD)
/UN_SENSE: U4.41 (GPIO29_ADC3); also elsewhere on the board
/USB_DM: J5.2, R5.2
/USB_DP: J5.1, R6.1
/V0: J3.5, U1.1 (VOUT)
/V1: J3.7, U3.1 (VOUT)
/Vm: U4.39 (GPIO27_ADC1); also elsewhere on the board
/heater_pwm: U4.30 (GPIO19); also elsewhere on the board
CAN+: J3.11, R36.2, U12.7 (CANH)
CAN-: J3.12, R37.2, U12.6 (CANL)
GND: C1.2, C2.1, C3.2, C4.2, C5.2, C6.2, C7.2, C8.1, C9.1, C11.2, C12.2, C13.2, C14.2, C15.2, C16.1, C17.1, C18.2, C19.2, C20.1, C21.1, C22.2, C23.2, C36.1, C37.1, C38.2, D1.2 (A2), J1.1, J2.1, J3.1, J4.5, JP1.2 (B), JP2.2 (B), JP3.2 (B), JP4.1 (A), R1.1, R2.1, R3.1, SW1.2, U1.2 (VA), U1.6 (ADR0), U2.2 (GND), U3.2 (VA), U4.19 (TESTEN), U4.57 (GND), U5.4 (GND), U6.2 (GND), U11.9 (VSS), U12.2 (GND), U12.8 (STB), Y1.2, Y1.4, Y2.2, Y2.4; also elsewhere on the board
unnamed: C16.2, U4.20 (XIN), Y1.3
unnamed: C17.2, U4.21 (XOUT), Y1.1
unnamed: C38.1, R36.1, R37.1
unnamed: D2.1 (K), R1.2
unnamed: D3.1 (K), R2.2
unnamed: D4.1 (K), R3.2
unnamed: JP4.2 (B), R7.2
unnamed: R5.1, U4.46 (USB_DM)
unnamed: R6.2, U4.47 (USB_DP)
unnamed: R7.1, R8.1, U4.56 (QSPI_SS), U5.1 (~CS)
unnamed: R35.1, U11.17 (~RESET)
unnamed: U4.51 (QSPI_SD3), U5.7 (IO3)
unnamed: U4.52 (QSPI_SCLK), U5.6 (CLK)
unnamed: U4.53 (QSPI_SD0), U5.5 (DI(IO0))
unnamed: U4.54 (QSPI_SD2), U5.3 (IO2)
unnamed: U4.55 (QSPI_SD1), U5.2 (DO(IO1))
unnamed: U11.1 (TXCAN), U12.4 (RXD)
unnamed: U11.2 (RXCAN), U12.1 (TXD)
VDDA: C19.1, U4.43 (ADC_AVDD); also elsewhere on the board

Notes on the sheet:
grey
ADC & USB
black
white
red
IOVDD DECOUPLING
yellow
DVDD DECOUPLING
green

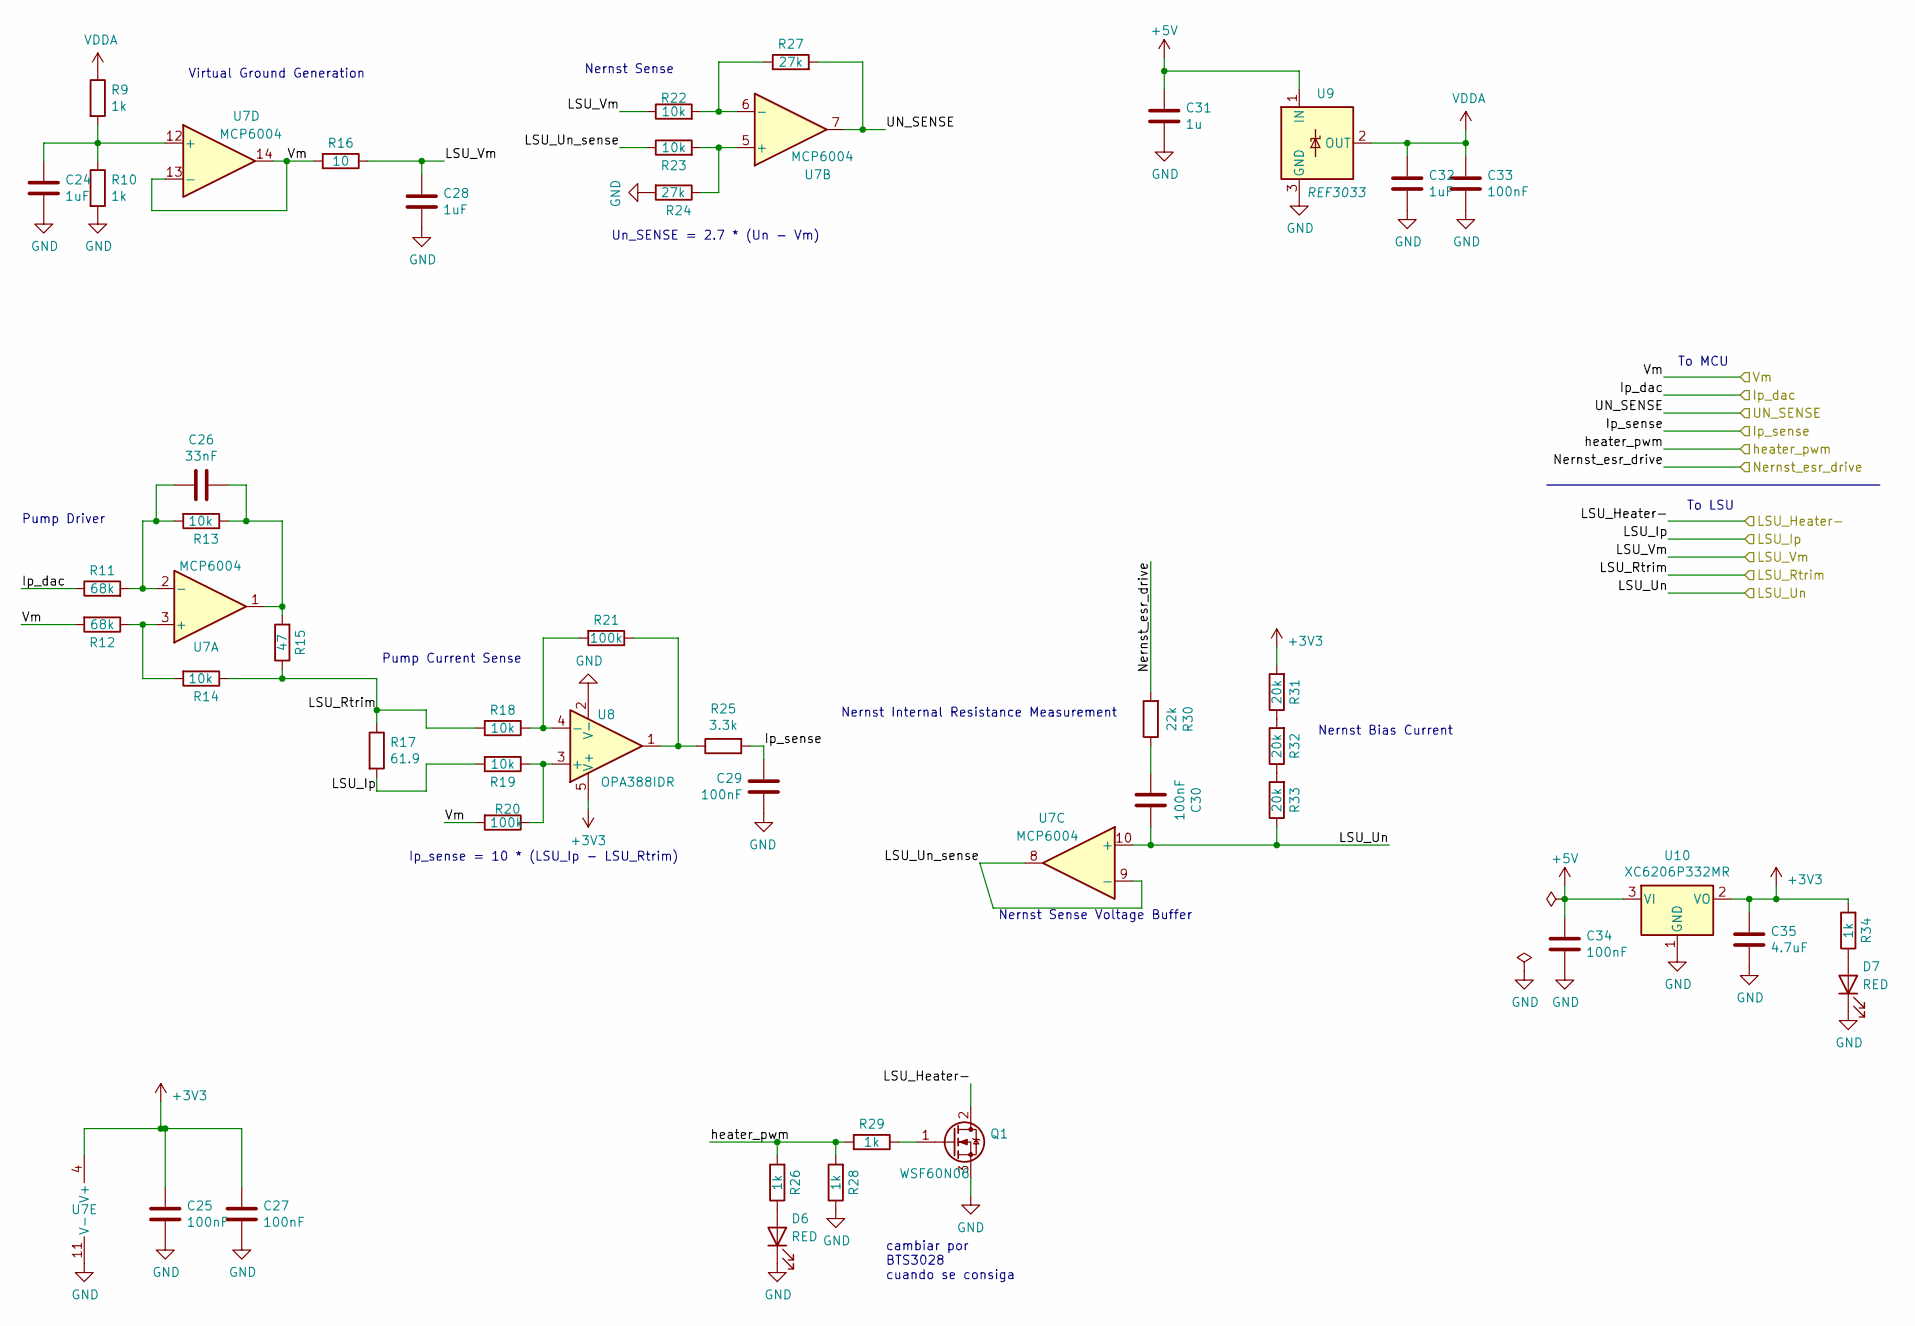
[picture p13: schematic wideband.kicad_sch]

Parts:
C24, C28, C32: 1uF; R_0603_1608Metric; LCSC C52923
C25, C27, C29, C30, C33, C34: 100nF; R_0603_1608Metric; LCSC C1525
C26: 33nF; R_0603_1608Metric; LCSC C1585
C31: 1u; R_0603_1608Metric; LCSC C52923
C35: 4.7uF; C_0603_1608Metric; LCSC C19666
D6, D7: RED; LED_0603_1608Metric; LCSC C2286
Q1: WSF60N06; TO-252-2; LCSC C148432
R9, R10, R26, R28, R29, R34: 1k; R_0603_1608Metric; LCSC C11702
R11, R12: 68k; R_0603_1608Metric; LCSC C36871
R13, R14, R18, R19, R22, R23: 10k; R_0603_1608Metric; LCSC C25744
R15: 47; R_0603_1608Metric; LCSC C25118
R16: 10; R_0603_1608Metric; LCSC C25077
R17: 61.9; R_0603_1608Metric; LCSC C23092
R20, R21: 100k; R_0603_1608Metric; LCSC C25741
R24, R27: 27k; R_0603_1608Metric; LCSC C25771
R25: 3.3k; R_0603_1608Metric; LCSC C25890
R30: 22k; R_0603_1608Metric; LCSC C25768
R31, R32, R33: 20k; R_0603_1608Metric; LCSC C25765
U7: MCP6004; TSSOP-14_4.4x5mm_P0.65mm; LCSC C50282
U8: OPA388IDR; TSOT-23-5; LCSC C154118
U9: REF3033; SOT-23; LCSC C36658
U10: XC6206P332MR; SOT-23; LCSC C5446

Connections:
+3V3: C25.1, C27.1, C35.1, R31.2, R34.2, U7.4 (V+), U8.5 (V+), U10.2 (VO); also elsewhere on the board
+5V: C31.1, C34.1, U9.1 (IN), U10.3 (VI); also elsewhere on the board
/Ip_dac: R11.1; also elsewhere on the board
/Ip_sense: C29.1, R25.2; also elsewhere on the board
/LSU_Heater-: Q1.2 (D); also elsewhere on the board
/LSU_Ip: R17.2, R19.2; also elsewhere on the board
/LSU_Rtrim: R14.1, R15.1, R17.1, R18.2; also elsewhere on the board
/LSU_Un: C30.1, R33.1, U7.10 (+); also elsewhere on the board
/LSU_Vm: C28.1, R16.1, R22.1; also elsewhere on the board
/Nernst_esr_drive: R30.2; also elsewhere on the board
/UN_SENSE: R27.2, U7.7; also elsewhere on the board
/Vm: R12.2, R16.2, R20.2, U7.13 (-), U7.14; also elsewhere on the board
/Wideband/LSU_Un_sense: R23.1, U7.8, U7.9 (-)
/heater_pwm: R26.2, R28.2, R29.2; also elsewhere on the board
GND: C24.2, C25.2, C27.2, C28.2, C29.2, C31.2, C32.2, C33.2, C34.2, C35.2, D6.1 (K), D7.1 (K), Q1.3 (S), R10.2, R24.2, R28.1, U7.11 (V-), U8.2 (V-), U9.3 (GND), U10.1 (GND); also elsewhere on the board
unnamed: C24.1, R9.2, R10.1, U7.12 (+)
unnamed: C26.1, R13.1, R15.2, U7.1
unnamed: C26.2, R11.2, R13.2, U7.2 (-)
unnamed: C30.2, R30.1
unnamed: D6.2 (A), R26.1
unnamed: D7.2 (A), R34.1
unnamed: Q1.1 (G), R29.1
unnamed: R12.1, R14.2, U7.3 (+)
unnamed: R18.1, R21.2, U8.4 (-)
unnamed: R19.1, R20.1, U8.3 (+)
unnamed: R21.1, R25.1, U8.1
unnamed: R22.2, R27.1, U7.6 (-)
unnamed: R23.2, R24.1, U7.5 (+)
unnamed: R31.1, R32.2
unnamed: R32.1, R33.2
VDDA: C32.1, C33.1, R9.1, U9.2 (OUT); also elsewhere on the board

Notes on the sheet:
Nernst Sense
Nernst Internal Resistance Measurement
Virtual Ground Generation
To LSU
Nernst Sense Voltage Buffer
Nernst Bias Current
Pump Driver
cambiar por BTS3028 cuando se consiga
Ip_sense = 10 * (LSU_Ip - LSU_Rtrim)
To MCU
Un_SENSE = 2.7 * (Un - Vm)
Pump Current Sense

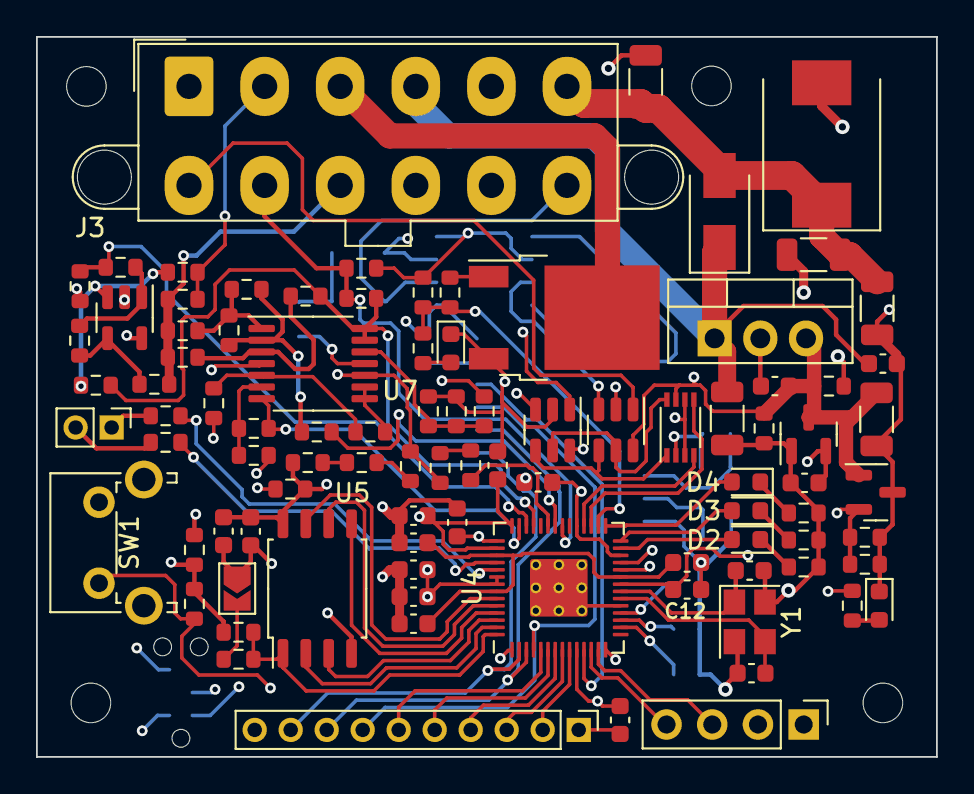
[picture p14: board wideband_v2.kicad_pcb from above]

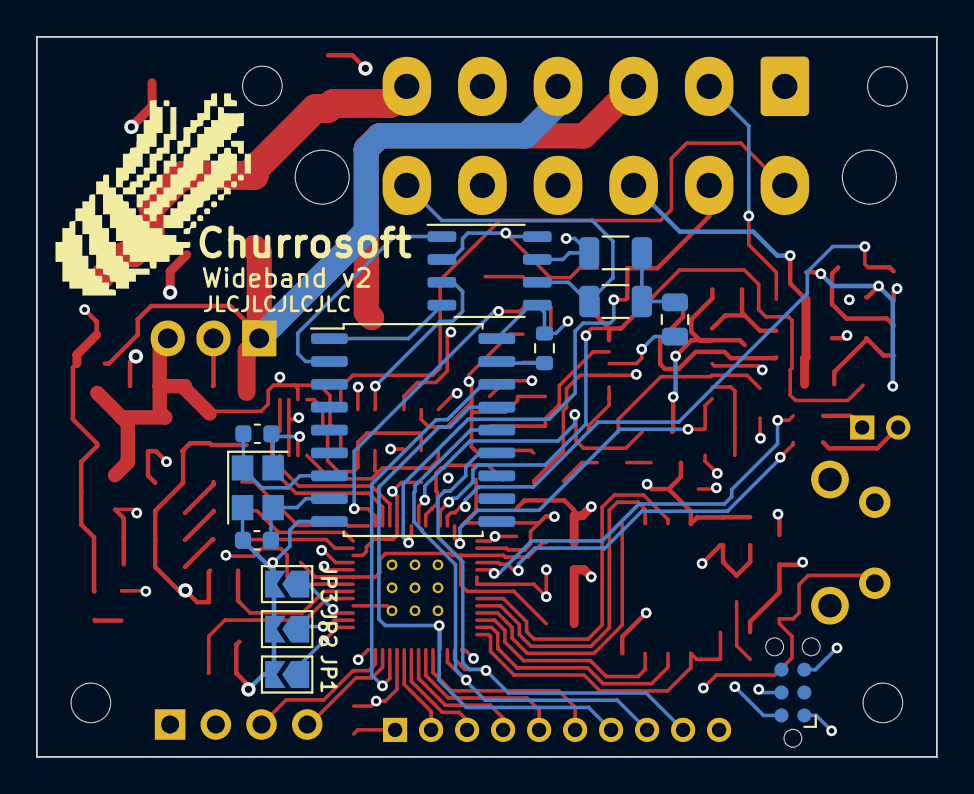
[picture p15: board wideband_v2.kicad_pcb from below]

Board: 4 copper layers, 50.0 x 40.0 mm, 111 parts (14 on the bottom side), 84 nets.

Other parts of the board:
Churrosoft: SYM_Hot_Large; churro_new_v4
