Churrosoft/OpenEFI-Wideband/pcb/wideband_v1/wideband_v1.kicad_pcb

## KiCad design pcb/wideband_v1/wideband_v1.kicad_pcb (2022-03-07, an earlier design)

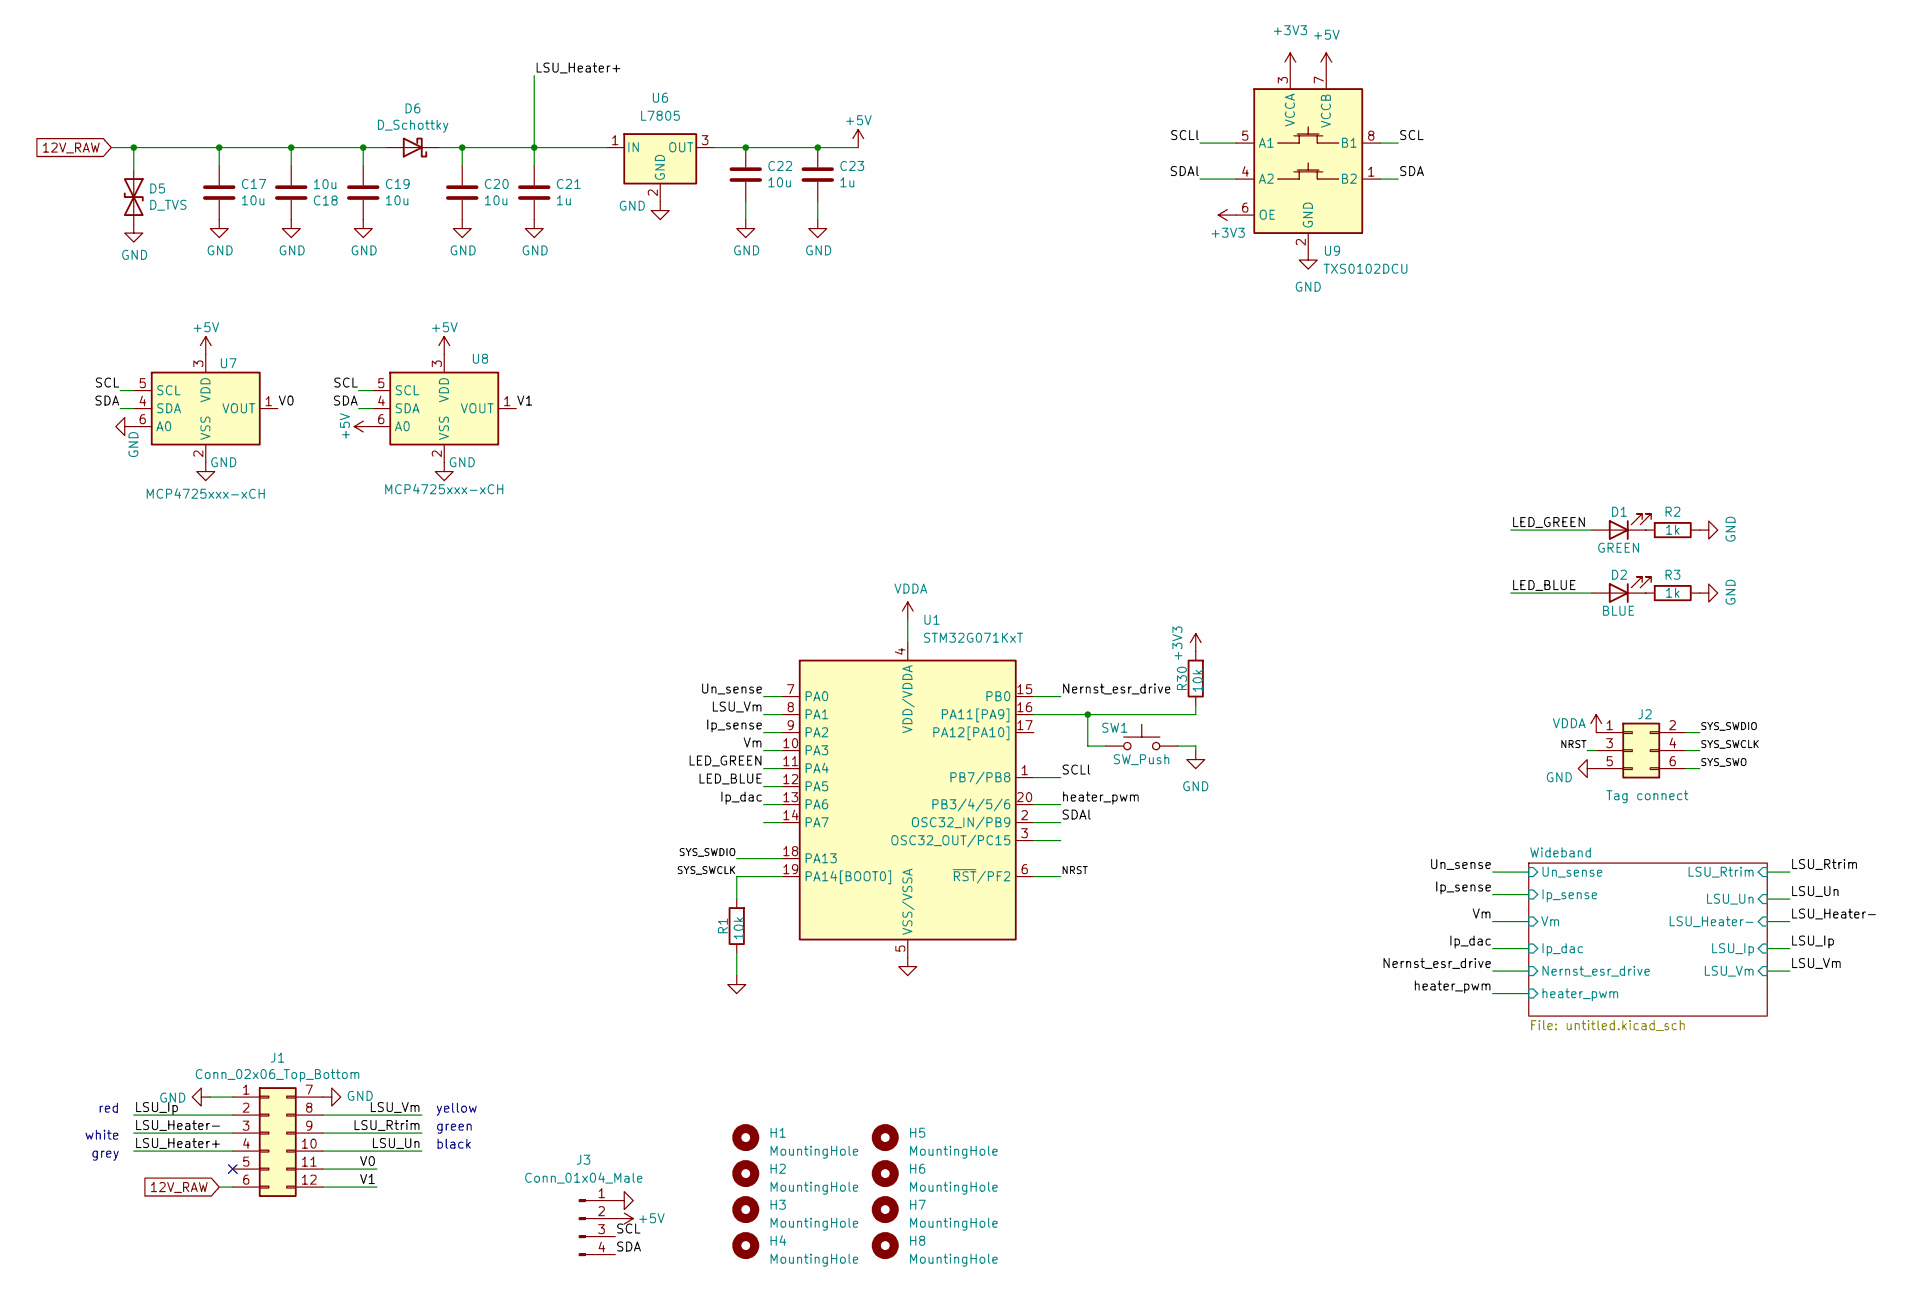
[picture p16: schematic wideband_v1.kicad_sch, OpenEFI - Wideband]

Parts:
C17, C18, C19, C20, C22: 10u; C_1206_3216Metric; LCSC C13585
C21, C23: 1u; C_0603_1608Metric; LCSC C15849
D1: GREEN; LED_0603_1608Metric; LCSC C72043
D2: BLUE; LED_0603_1608Metric; LCSC C72041
D5: D_TVS; D_SMC; LCSC C151279
D6: D_Schottky; D_SMA; LCSC C22452
H1, H2, H3, H4: MountingHole; MountingHole_2.2mm_M2
H5, H6, H7, H8: MountingHole; Fiducial_1mm_Mask2mm
J1: Conn_02x06_Top_Bottom; Molex_Mini-Fit_Jr_5566-12A2_2x06_P4.20mm_Vertical
J2: Tag connect; Tag-Connect_TC2030-IDC-NL_2x03_P1.27mm_Vertical
J3: Conn_01x04_Male; PinHeader_1x04_P2.54mm_Vertical
R1, R30: 10k; R_0603_1608Metric; LCSC C25744
R2, R3: 1k; R_0603_1608Metric; LCSC C11702
SW1: SW_Push; SW_Tactile_SPST_Angled_PTS645Vx83-2LFS
U1: STM32G071KxT; TSSOP-20_4.4x6.5mm_P0.65mm
U6: L7805; TO-220-3_Vertical
U7, U8: MCP4725xxx-xCH; SOT-23-6
U9: TXS0102DCU; VSSOP-8_2.3x2mm_P0.5mm

Connections:
12V_RAW: C17.1, C18.2, C19.1, D5.1 (A1), D6.2 (A), J1.6
+5V: C22.1, C23.1, J3.2, U6.3 (OUT), U7.3 (VDD), U8.3 (VDD), U8.6 (A0), U9.7 (VCCB); also elsewhere on the board
/Ip_dac: U1.13 (PA6); also elsewhere on the board
/Ip_sense: U1.9 (PA2); also elsewhere on the board
/LED_BLUE: D2.2 (A), U1.12 (PA5)
/LED_GREEN: D1.2 (A), U1.11 (PA4)
/LSU_Heater+: C20.1, C21.1, D6.1 (K), J1.4, U6.1 (IN)
/LSU_Heater-: J1.3; also elsewhere on the board
/LSU_Ip: J1.2; also elsewhere on the board
/LSU_Rtrim: J1.9; also elsewhere on the board
/LSU_Un: J1.10; also elsewhere on the board
/LSU_Vm: J1.8, U1.8 (PA1); also elsewhere on the board
/NRST: J2.3, U1.6 (~RST/PF2)
/Nernst_esr_drive: U1.15 (PB0); also elsewhere on the board
/SCL: J3.3, U7.5 (SCL), U8.5 (SCL), U9.8 (B1)
/SCLl: U1.1 (PB7/PB8), U9.5 (A1)
/SDA: J3.4, U7.4 (SDA), U8.4 (SDA), U9.1 (B2)
/SDAl: U1.2 (OSC32_IN/PB9), U9.4 (A2)
/SYS_SWCLK: J2.4, R1.2, U1.19 (PA14[BOOT0])
/SYS_SWDIO: J2.2, U1.18 (PA13)
/SYS_SWO: J2.6
/Un_sense: U1.7 (PA0); also elsewhere on the board
/V0: J1.11, U7.1 (VOUT)
/V1: J1.12, U8.1 (VOUT)
/Vm: U1.10 (PA3); also elsewhere on the board
/heater_pwm: U1.20 (PB3/4/5/6); also elsewhere on the board
GND: C17.2, C18.1, C19.2, C20.2, C21.2, C22.2, C23.2, D5.2 (A2), J1.1, J1.7, J2.5, J3.1, R1.1, R2.1, R3.1, SW1.2, U1.5 (VSS/VSSA), U6.2 (GND), U7.2 (VSS), U7.6 (A0), U8.2 (VSS), U9.2 (GND); also elsewhere on the board
unnamed: D1.1 (K), R2.2
unnamed: D2.1 (K), R3.2
unnamed: R30.1, SW1.1, U1.16 (PA11[PA9])
VDDA: J2.1, U1.4 (VDD/VDDA); also elsewhere on the board

Notes on the sheet:
white
yellow
black
green
red
grey

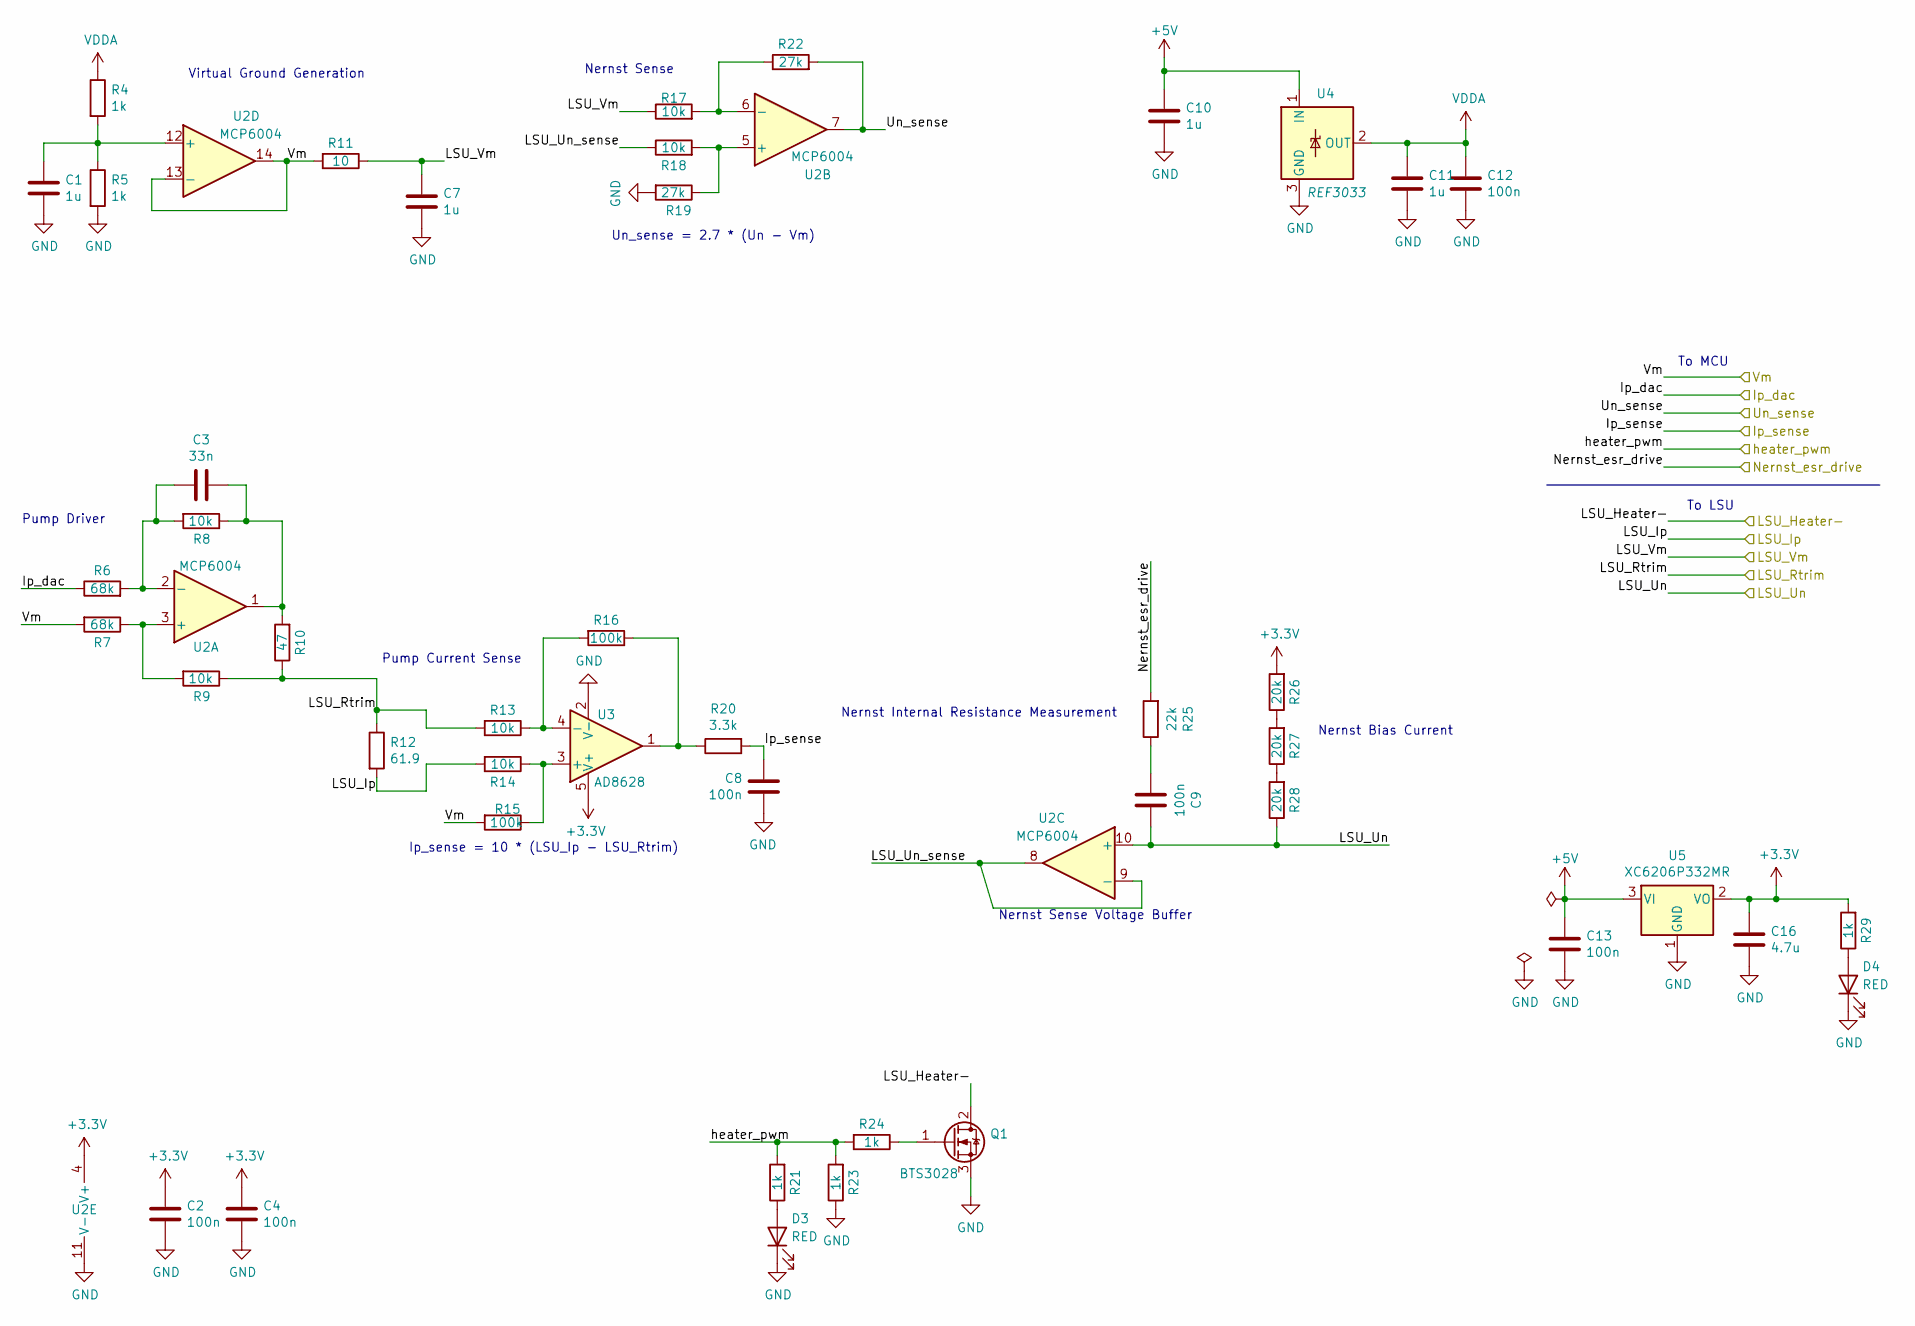
[picture p17: schematic untitled.kicad_sch, OpenEFI - Wideband]

Parts:
C1, C7, C10, C11: 1u; R_0603_1608Metric; LCSC C52923
C2, C4, C8, C9, C12, C13: 100n; R_0603_1608Metric; LCSC C1525
C3: 33n; R_0603_1608Metric; LCSC C1585
C16: 4.7u; C_0603_1608Metric; LCSC C19666
D3, D4: RED; LED_0603_1608Metric; LCSC C2286
Q1: BTS3028; TO-252-2; LCSC C112639
R4, R5, R21, R23, R24, R29: 1k; R_0603_1608Metric; LCSC C11702
R6, R7: 68k; R_0603_1608Metric; LCSC C36871
R8, R9, R13, R14, R17, R18: 10k; R_0603_1608Metric; LCSC C25744
R10: 47; R_0603_1608Metric; LCSC C25118
R11: 10; R_0603_1608Metric; LCSC C25077
R12: 61.9; R_0603_1608Metric; LCSC C23092
R15, R16: 100k; R_0603_1608Metric; LCSC C25741
R19, R22: 27k; R_0603_1608Metric; LCSC C25771
R20: 3.3k; R_0603_1608Metric; LCSC C25890
R25: 22k; R_0603_1608Metric; LCSC C25768
R26, R27, R28: 20k; R_0603_1608Metric; LCSC C25765
U2: MCP6004; TSSOP-14_4.4x5mm_P0.65mm; LCSC C50282
U3: AD8628; TSOT-23-5; LCSC C29309
U4: REF3033; SOT-23; LCSC C36658
U5: XC6206P332MR; SOT-23; LCSC C5446

Connections:
+5V: C10.1, C13.1, U4.1 (IN), U5.3 (VI); also elsewhere on the board
/Ip_dac: R6.1; also elsewhere on the board
/Ip_sense: C8.1, R20.2; also elsewhere on the board
/LSU_Heater-: Q1.2 (D); also elsewhere on the board
/LSU_Ip: R12.2, R14.2; also elsewhere on the board
/LSU_Rtrim: R9.1, R10.1, R12.1, R13.2; also elsewhere on the board
/LSU_Un: C9.1, R28.1, U2.10 (+); also elsewhere on the board
/LSU_Vm: C7.1, R11.1, R17.1; also elsewhere on the board
/Nernst_esr_drive: R25.2; also elsewhere on the board
/Un_sense: R22.2, U2.7; also elsewhere on the board
/Vm: R7.2, R11.2, R15.2, U2.13 (-), U2.14; also elsewhere on the board
/Wideband/LSU_Un_sense: R18.1, U2.8, U2.9 (-)
/heater_pwm: R21.2, R23.2, R24.2; also elsewhere on the board
GND: C1.2, C2.2, C4.2, C7.2, C8.2, C10.2, C11.2, C12.2, C13.2, C16.2, D3.1 (K), D4.1 (K), Q1.3 (S), R5.2, R19.2, R23.1, U2.11 (V-), U3.2 (V-), U4.3 (GND), U5.1 (GND); also elsewhere on the board
unnamed: C1.1, R4.2, R5.1, U2.12 (+)
unnamed: C3.1, R8.1, R10.2, U2.1
unnamed: C3.2, R6.2, R8.2, U2.2 (-)
unnamed: C9.2, R25.1
unnamed: D3.2 (A), R21.1
unnamed: D4.2 (A), R29.1
unnamed: Q1.1 (G), R24.1
unnamed: R7.1, R9.2, U2.3 (+)
unnamed: R13.1, R16.2, U3.4 (-)
unnamed: R14.1, R15.1, U3.3 (+)
unnamed: R16.1, R20.1, U3.1
unnamed: R17.2, R22.1, U2.6 (-)
unnamed: R18.2, R19.1, U2.5 (+)
unnamed: R26.1, R27.2
unnamed: R27.1, R28.2
VDDA: C11.1, C12.1, R4.1, U4.2 (OUT); also elsewhere on the board

Notes on the sheet:
Virtual Ground Generation
Ip_sense = 10 * (LSU_Ip - LSU_Rtrim)
To MCU
Un_sense = 2.7 * (Un - Vm)
To LSU
Pump Driver
Nernst Bias Current
Nernst Internal Resistance Measurement
Nernst Sense
Nernst Sense Voltage Buffer
Pump Current Sense

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
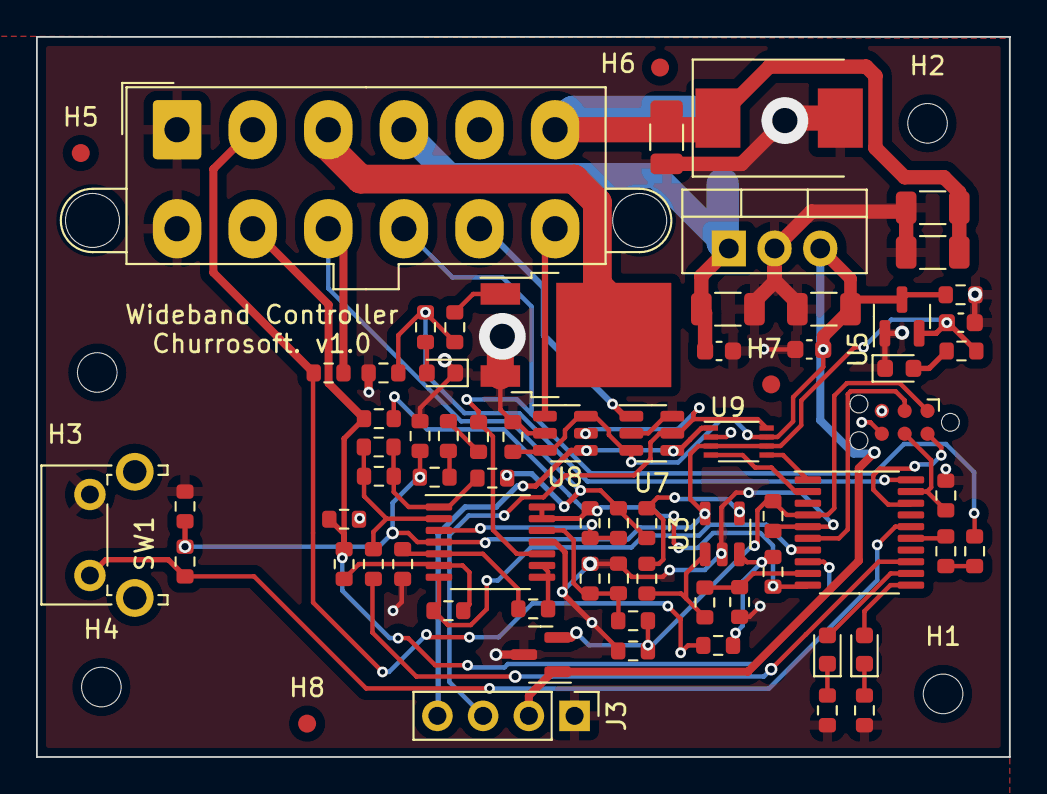
[picture p18: board wideband_v1.kicad_pcb from above]

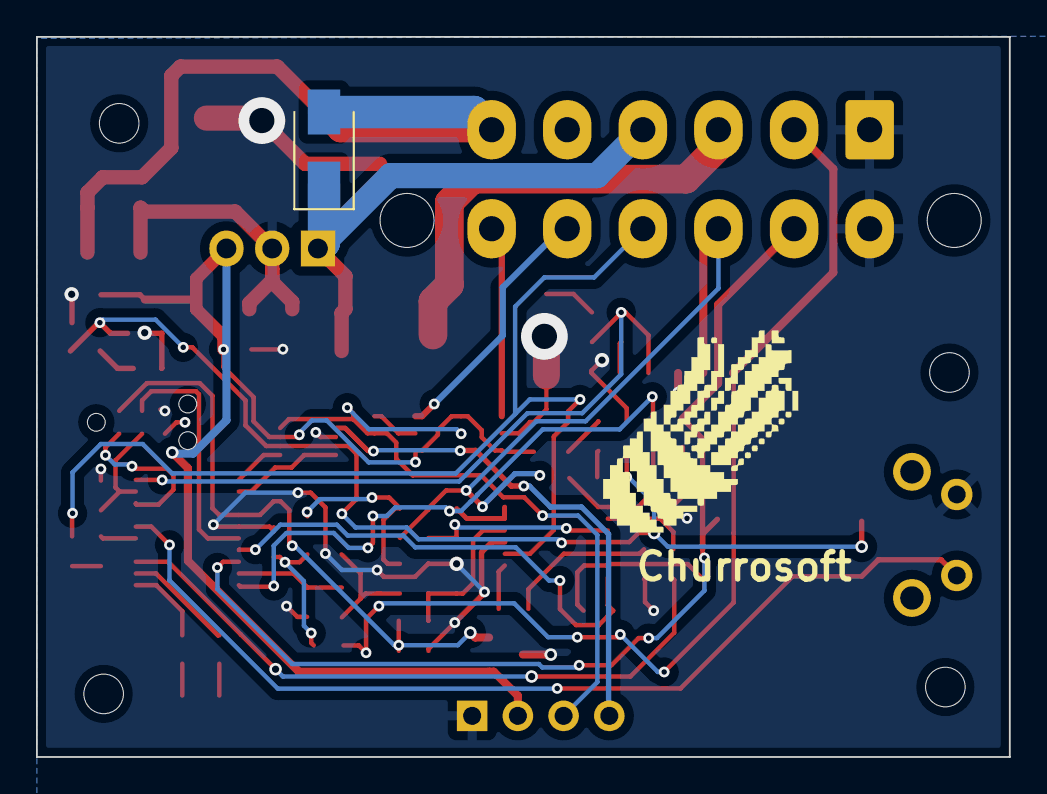
[picture p19: board wideband_v1.kicad_pcb from below]

Board: 2 copper layers, 54.1 x 40.0 mm, 79 parts (2 on the bottom side), 47 nets.

Other parts of the board:
Churrosoft: SYM_Hot_Large; churro_new_v4
Churrosoft#2: SYM_Hot_Large; churro_new_v4
