Churrosoft/OpenEFI-Wideband/cube/cube.ioc

Mcu.UserName=STM32G030F6Px
PA0.GPIO_Label=Un_sense
PA0.Signal=ADC1_IN0
PA1.GPIO_Label=LSU_Vm
PA1.Signal=ADC1_IN1
PA13.Signal=SYS_SWDIO
PA14-BOOT0.Signal=SYS_SWCLK
PA2.GPIO_Label=LSU_Vm
PA2.Signal=ADC1_IN2
PA3.GPIO_Label=Vm
PA3.Signal=ADC1_IN3
PA4.GPIO_Label=LED_RED
PA4.Signal=GPIO_Output
PA5.GPIO_Label=LED_GREEN
PA5.Signal=GPIO_Output
PA6.GPIO_Label=Ip_dac
PA6.Signal=S_TIM3_CH1
PA7.GPIO_Label=LED_ZEPPELIN
PA7.Signal=GPIO_Output
PB0.GPIO_Label=Nernst_esr_drive
PB0.Signal=GPIO_Output
PB3.GPIO_Label=heater_pwm
PB3.Signal=S_TIM1_CH2
PB8.Signal=I2C1_SCL
PB9.Signal=I2C1_SDA
