Churrosoft/OpenEFI-Wideband/carrier_fw/src/main.h

#pragma once

#include <Arduino.h>
#include "pico/stdlib.h"

extern "C"
{
#include "can2040.h"
}

extern struct can2040 cbus_wbo;

extern uint32_t currentO2;

// TODO: configurable por el pulsador/USB
static uint32_t stoich = 147000;

void sendRusEfiWbo(struct can2040_msg *msg);
