Churrosoft/OpenEFI-Wideband/(commit log)

2022-03-07 v1 of pcb
    [untitled.kicad_sch, wideband_v1.kicad_pcb, wideband_v1.kicad_sch, wideband_v1_bkp.kicad_sch]
2022-07-08 init rp2040 firmware, added heater_control basis
2022-07-10 added heater control state machine
2022-07-12 Wideband v2
    [wideband.kicad_sch, wideband_v2.kicad_pcb, wideband_v2.kicad_sch]
2022-07-12 Updating BOM SKUs
    [wideband_v2.kicad_pcb, wideband_v2.kicad_sch]
2022-07-12 MCP4725 => DAC5571
    [wideband_v2.kicad_pcb, wideband_v2.kicad_sch]
2022-07-12 Fix SKUs. Upload JLC database
    [wideband_v2.kicad_pcb]
2022-07-12 BTS3028 => WSF60N06 | AD8628 => OPA388IDR
    [wideband.kicad_sch, wideband_v2.kicad_pcb, wideband_v2.kicad_sch]
2022-07-12 added heater thread
2022-07-12 tune tracks/vias
    [wideband_v2.kicad_pcb]
2022-07-13 add CAN controller
    [wideband_v2.kicad_pcb, wideband_v2.kicad_sch]
2022-07-13 trace external i/o
    [wideband_v2.kicad_pcb, wideband_v2.kicad_sch]
2023-11-29 created v3 sch
    [Wideband_v3.kicad_pcb, Wideband_v3.kicad_sch, mcu.kicad_sch, power.kicad_sch, untitled.kicad_sch]
2023-11-30 update pcb layout
    [Wideband_v3.kicad_pcb, Wideband_v3.kicad_sch, mcu.kicad_sch]
2023-12-04 init 7seg pcb
    [39-28-1043--3DModel-STEP-361473.STEP, 462071012.stp, 7_Segment_LED_v1.kicad_pcb, 7_Segment_LED_v1.kicad_sch, DL7A-3 RED.step, Wideband_v3.kicad_pcb, Wideband_v3.kicad_sch, mcu.kicad_sch]
2023-12-05 Code SKUs
    [Wideband_v3.kicad_pcb, mcu.kicad_sch]
2023-12-05 rev3, reduce extended component count
    [7_Segment_LED_v1.kicad_pcb, 7_Segment_LED_v1.kicad_sch, 7_Segment_neopixel.kicad_pcb, 7_Segment_neopixel.kicad_sch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]
2023-12-05 Optimize SKUs
    [Wideband_v3-CuBottom.gbr, Wideband_v3-CuTop.gbr, Wideband_v3-EdgeCuts.gbr, Wideband_v3-MaskBottom.gbr, Wideband_v3-MaskTop.gbr, Wideband_v3-NPTH.drl, Wideband_v3-PTH.drl, Wideband_v3-PasteBottom.gbr]
2023-12-05 update DAC for v3
    [7_Segment_LED_v1.kicad_sch, Wideband_v3.kicad_pcb, Wideband_v3.kicad_sch, mcu.kicad_sch, power.kicad_sch]
2023-12-05 update 7seg footprint
    [7_Segment_LED_v1.kicad_pcb, 7_Segment_LED_v1.kicad_sch]
2023-12-06 rev3: update connector on main board
    [39-28-1043--3DModel-STEP-361473.STEP, 462071012.stp, 7_Segment_LED_v1.kicad_pcb, 7_Segment_LED_v1.kicad_sch, 7_Segment_neopixel.kicad_pcb, 7_Segment_neopixel.kicad_sch, DL7A-3 RED.step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]
2023-12-06 Bug fixes and enhancements
    [7_Segment_LED_v1.kicad_pcb, 7_Segment_LED_v1.kicad_sch, Wideband_v3.kicad_pcb]
2023-12-06 update transistors on rev3
    [7_Segment_LED_v1.kicad_pcb, 7_Segment_LED_v1.kicad_sch]
2024-03-22 update LCSC/Stock codes, update pcb to new footprints
    [Wideband_v3.kicad_pcb, Wideband_v3.kicad_sch, mcu.kicad_sch, power.kicad_sch]
2024-04-07 init fw
    [Wideband_v3.kicad_pcb]
2024-04-10 init canbus code for wbo module
2024-04-12 reorganize rev3 diagram, add display code to carrier fw
    [39-28-1043--3DModel-STEP-361473.STEP, 462071012.stp, 7_Segment_LED_v1.kicad_pcb, 7_Segment_LED_v1.kicad_sch, 7_Segment_neopixel.kicad_pcb, 7_Segment_neopixel.kicad_sch, DL7A-3 RED.step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]
2024-04-17 ya ni me acuerdo que hice, pero seguro era algo del display
