Churrosoft/OpenEFI-Wideband/(notices)

Notices in the files:
pcb/wideband_v3/untitled.kicad_sch:
CERN-OHL-S Licence
